hsean/ECE-411-Practicum/Pictures/Concept Pictures/Concept6_Render1.JPG

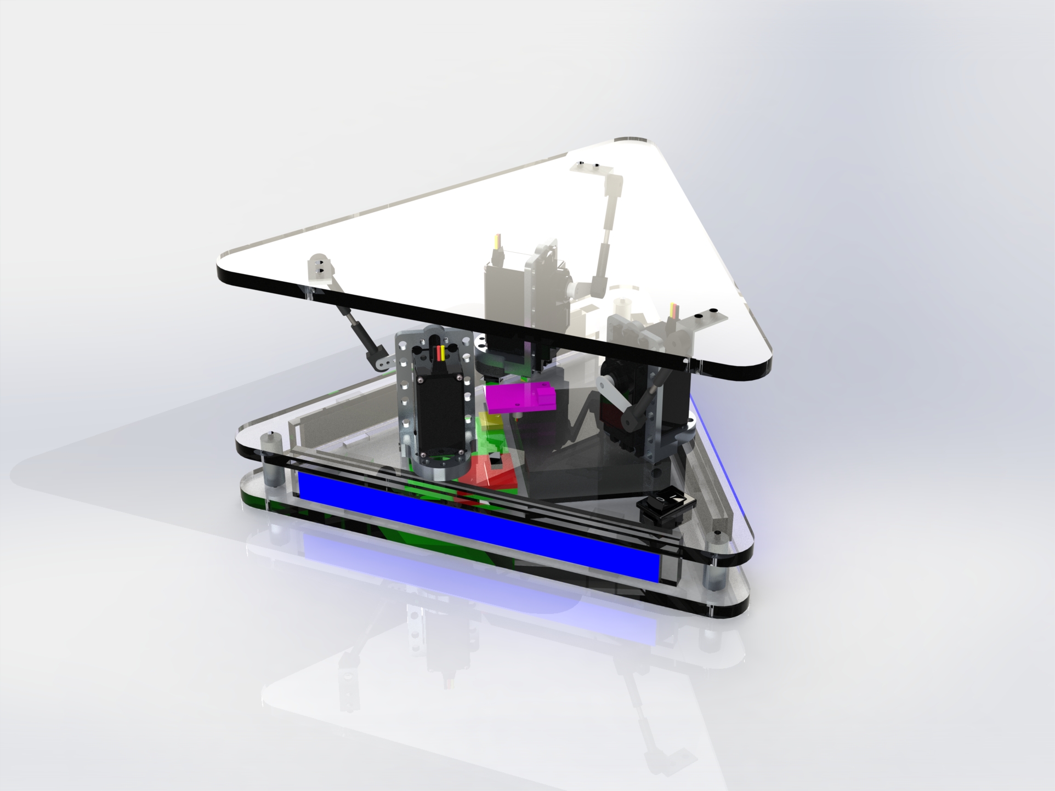
Pictures/Concept Pictures/Concept6_Render1.JPG
