hsean/ECE-411-Practicum/Pictures/Testing/TestProgramMicrocontroller.jpg

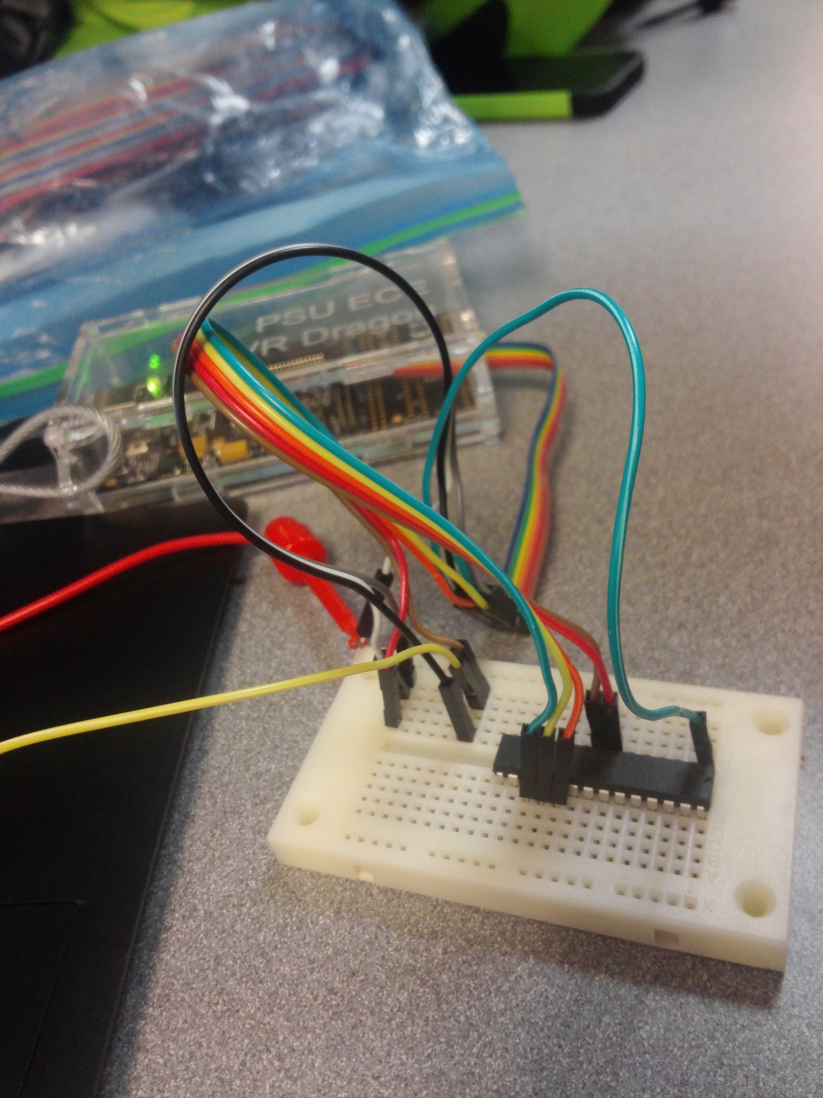
Pictures/Testing/TestProgramMicrocontroller.jpg
