hsean/ECE-411-Practicum/Code/Class Implementation/Readme.txt

The contents of this folder is an object oriented method
for organizing the code for Team 04's project.

Code was written in Visual Studio 2013 Professional.
The project solution thus far is provided in the folder.
