hsean/ECE-411-Practicum/Code/Example Code/BlinkLED/BlinkLED.txt

Taken from: https://electrosome.com/blinking-led-atmega32-avr-microcontroller/
