hsean/ECE-411-Practicum/Block Diagram/HW5_BlockDiagrams.pptx

## T04: Self Leveling Table

Sean Hendrickson
Waleed Alhaddad
Adrian Steele
Taylor Griffin

## Slide 2

Self Leveling Table: Level 0

Gravitational Accelerative Force

Power,
6 VDC

Self Leveling Table

System Status

LED angle
display

Module | Self Leveling Table
Inputs | - Gravitational Accelerative Force: The external forces acting on the device, used to determine the angle of the device and set servo position - Power: 6 VDC from batteries.
Outputs | - LED Angle Display: 15 LEDs lit up in different configurations. Lights up based on device tilt slowly changing colors. LEDs around the device become more blue on the device side that is tilted up. LEDs around the device become more red on the device side that is tilted down. - System status: 4 LEDs that light up on PCB. First LED is green, displays when tilt on the x axis reaches its limit. Second LED is yellow, displays when there is communication between the microcontroller and the servo controller. Third LED is yellow, displays when there is communication between the microcontroller and 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
Functionality | - Consists of 2 layers: the base (two triangular acrylic sheets enclosing the batteries, PCB, servos, and LEDs), and the top tray (one triangular acrylic sheet leveled by servos). Receives input from an accelerometer and determines servo position to keep the top tray level.

## Slide 3

Self Leveling Table Design: Level 1

Oscillator

Gravitational Accelerative Force

Accelerometer

Accelerometer
Initialization

Microcontroller

clock

x y z
values

Status info

Status LEDs

Servo Controller

System Status

3.3 VDC

LED strip
control

Servo
settings
and
positions

Servo 1

Voltage Regulator
6V to 3.3V

PWM
signal
specifying
servo arm
position

Servo 2

Leveled
table

Logic level shifter

Shifted LED
Strip control

Shifted
servo positions

Servo 3

Voltage Regulator
6V to 5V

5 VDC

LED Strip

LED angle
display

Power,
6 VDC

## Slide 4

Accelerometer: Level 0

Gravitational Accelerative Force

Accelerometer Initialization

Power,
3.3 VDC

Accelerometer

x y z values

Module | Accelerometer
Inputs | - Gravitational Accelerative Force: The accelerative force acting on the accelerometer - Power: Regulated 3.3 VDC - Accelerometer Initialization: Set 50 Hz sample rate, fast read mode (ignore last 4 data bits for x y z output), and activate output. Communicated via TWI. TWI format - send start condition, send accelerometer slave address (0x3A), send register to write to (0x23 - system control register 1), send value to put in register (0x23 - bit 5 = 1 bit 4 = 0 bit 3 = 0 data rate to 50 Hz, bit 1 = 1 fast read mode, bit 0 = 1 active mode), send stop condition.
Outputs | - x y z values: 8 most significant bits of 12, expressed in 2’s complement, representing 1 of 256 values on a ± 2 g scale transmitted over TWI
Functionality | - Measures the accelerative forces, and outputs the values of the x y z directions.

## Slide 5

Voltage Regulator 6V to 3.3V: Level 0

Voltage Regulator
6V to 3.3V

Power,
6 VDC

Power,
3.3 VDC

Module | Voltage Regulator 6V to 3.3V
Inputs | 6 V battery power supply
Outputs | Regulated 3.3 VDC
Functionality | - Lowers the incoming 5-20 volts down to a regulated 3.3 VDC, outputting up to 500 mA

## Slide 6

Voltage Regulator 6V to 5V: Level 0

Voltage Regulator
6V to 5V

Power,
6 VDC

Power,
5 VDC

Module | Voltage Regulator 6V to 5V
Inputs | 6 V battery power supply
Outputs | Regulated 5 VDC
Functionality | - Lowers the incoming 6-26 volts down to a regulated 5 VDC, outputting up to 1 A

## Slide 7

Microcontroller: Level 0

Power,
3.3 VDC

Clock

Microcontroller

LED Strip Control

Status info

Accelerometer Initialization

Servo Positions

x y z values

Servo settings

Module | Microcontroller
Inputs | - Power: Regulated 3.3 VDC - Clock: 8 MHz - x y z input: 8 most significant bits of 12, expressed in 2’s complement, representing 1 of 256 values on a ± 2 g scale transmitted over TWI
Outputs | - LED Strip control: which LEDs to light up. Communicated via SPI. Send 24 bit color pattern, shifted through the strip. - Status info: 4 LEDs representing transmission maximum tilt statuses. Using 3.3 V GPIO. 1 green LED displaying when the tilt on the x axis has reached its limit. 2 yellow LEDs displaying when there is communication between the microcontroller and the accelerometer/servo controller. 1 Red LED displaying when the tilt on the y axis has reached its limit. - Servo settings: Set the speed of the servos. speed limit is given in units of (0.25 μs)/(10 ms). Communicated via USART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
Functionality | - Converts x y z values to angles. Runs calculation of correct servo position based on input provided by accelerometer. Also sends LED strips configurations based on current servo positions. Displays system status via 4 LEDs on PCB

## Slide 8

Logic level shifter: Level 0

Power,
5 VDC

LED strip
control

Servo
positions

Logic level shifter

Shifted LED strip control

Shifted servo positions

Module | Logic Level Shifter
Inputs | Power: Regulated 5 VDC LED Strip Control: LED display signals coming from microcontroller Servo position: servo position signals coming from microcontroller
Outputs | Shifted LED Strip Control: Shifted LED signals from 3.3 to 5 V Shifted Servo position: Shifted servo position signals from 3.3 to 5 V
Functionality | - Shifts signals coming in from the microcontroller to a 5 V output

## Slide 9

Oscillator: Level 0

Oscillator

Clock

Module | Oscillator
Inputs
Outputs | Clock: 16 MHz
Functionality | - Sends the microcontroller an 8 MHz clock pulse

## Slide 10

Status LEDs: Level 0

Status LEDs

Status Info

System status

Module | Status LEDs
Inputs | - Status Info: High or low signal depending on which LEDs to turn on. Communicated via 3.3 V GPIO
Outputs | - System status: 4 LEDs that light up on PCB. First LED is green, displays when tilt on the x axis reaches its limit. Second LED is yellow, displays when there is communication between the microcontroller and the servo controller. Third LED is yellow, displays when there is communication between the microcontroller and the accelerometer. Fourth LED is red, displays when the tilt on the y axis reaches its limit.
Functionality | - Displays status information including what transmissions are occurring (TWI, USART) and any errors

## Slide 11

Servo Controller: Level 0

Servo Controller

Power,
5 VDC

Servo positions

PWM signal

Module | Servo Controller
Inputs | - Servo settings: Set the speed of the servos. speed limit is given in units of (0.25 μs)/(10 ms). Communicated via USART. Incoming communications can have varying baud rates but the ideal baud rate is 9600. Transmissions must follow the pololu protocol format and be transmitted one byte at a time (0xAA baud rate detection byte, 0x0C device ID of servo controller, 0x07 command byte to set servo speed, <channel number> channel of the servo that you want to set the speed, <servo speed MSB> least significant byte of speed value, <servo speed MSB> most significant byte of speed value) - Power: R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
Outputs | - Servo positions: Pulse width modulation signal to corresponding servo. Generates a pulse of a certain frequency to send to the servo what position it should hold. Done automatically, just need to receive input on what position to set the servo to.
Functionality | - Creating pulse width modulated signals to control up to 6 servos.

## Slide 12

LED Strip: Level 0

LED Strip

Power,
5 VDC

LED Angle Display

LED Strip control

Module | LED Strip
Inputs | Power: Regulated 5 VDC LED Strip control: which LEDs to light up. Communicated via SPI. Send 24 bit color pattern, shifted through the strip.
Outputs | Power: Regulated 5 VDC LED Strip control: which LEDs to light up. Communicated via SPI. Send 24 bit color pattern, shifted through the strip.
Functionality | - Decorative LED display based on each servo’s position. Should not consume more than 1 A. Multicolored.

## Slide 13

Servos: Level 0

Servos

Power,
6 VDC

Leveled Table

PWM signal

Module | LED Strip
Inputs | - Power: 6 VDC - Servo positions: Pulse width modulation signal to corresponding servo. Generates a pulse of a certain frequency to send to the servo what position it should hold. Done automatically, just need to receive input on what position to set the servo to.
Outputs | Leveled table: Adjust servo positions to level the top tray
Functionality | - The servo position is determined by the main program so that they keep the tray balanced. Range of 140°

## UML: Activity Diagram

Power on device

Set servos to home position

Initialize accelerometer

Sample Accelerometer

Convert accelerometer data to angles

Calculate servo positions

If servo positions different by 4 degrees or more

No

Yes

Send positions to servos

Update LED strip

Delay

Repeat until powered off

*Note: Update status LEDs after every communication and calculation and in the event of an error.

## UML: Interaction Diagram

Accelerometer

Status LEDs

Microprocessor

LED Strip

1. Set servo speed and move them to home position

Servo Controller

Servos

3. Move servos

4. Initialize Accelerometer

6. Request accelerometer data

7. Transmit accelerometer data

8. Update Status

9. Calculate
servo positions

11. Update Status

10. Send positions to servos if previous
Position differs by 4 or more degrees

12. Move servos

13. Update LED Strip

15. Repeat steps 6 - 15
