hsean/ECE-411-Practicum/Code/DotStar_Code/Pictures/C Code.JPG

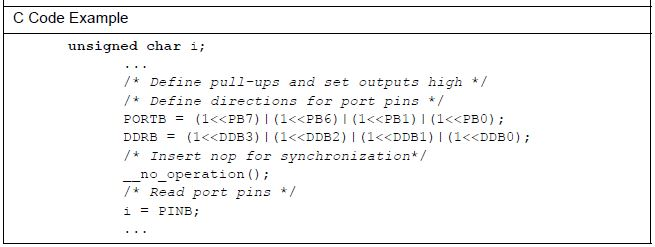
Code/DotStar_Code/Pictures/C Code.JPG
