hsean/ECE-411-Practicum/Code/DotStar_Code/Pictures/Configuring GPIO pin.JPG

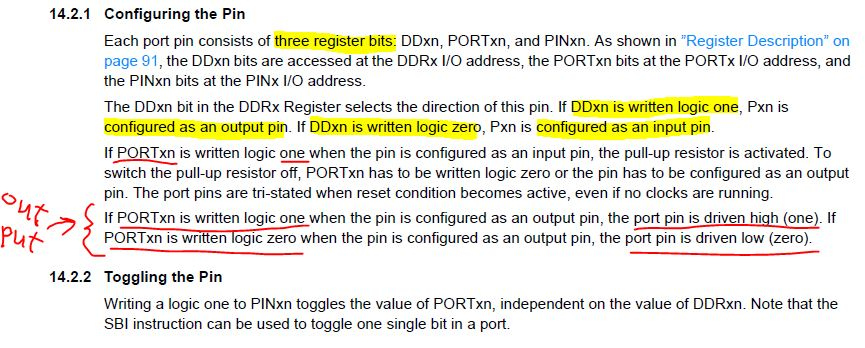
Code/DotStar_Code/Pictures/Configuring GPIO pin.JPG
