hsean/ECE-411-Practicum/Code/DotStar_Code/Pictures/Data Structure.JPG

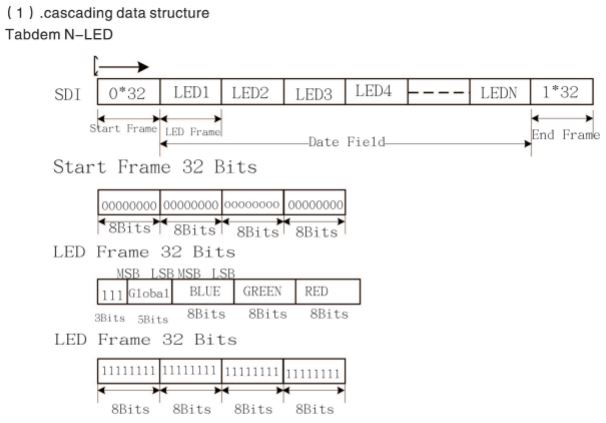
Code/DotStar_Code/Pictures/Data Structure.JPG
