hsean/ECE-411-Practicum/Code/DotStar_Code/Pictures/Dotstar datapath.JPG

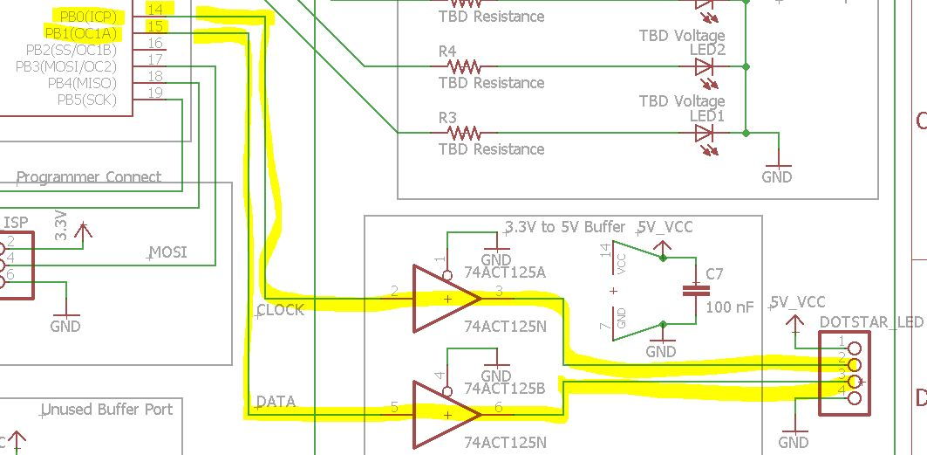
Code/DotStar_Code/Pictures/Dotstar datapath.JPG
