hsean/ECE-411-Practicum/Code/DotStar_Code/Pictures/Dotstar pinout.JPG

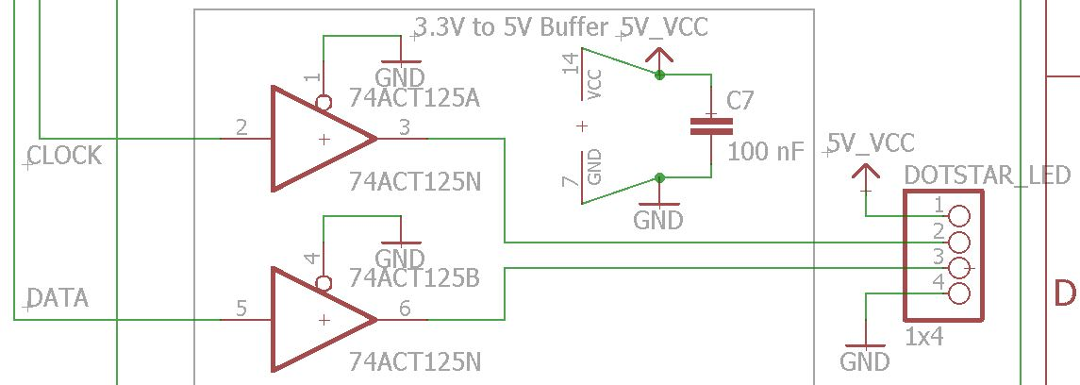
Code/DotStar_Code/Pictures/Dotstar pinout.JPG
