hsean/ECE-411-Practicum/Code/DotStar_Code/Pictures/MCPins&Ports.JPG

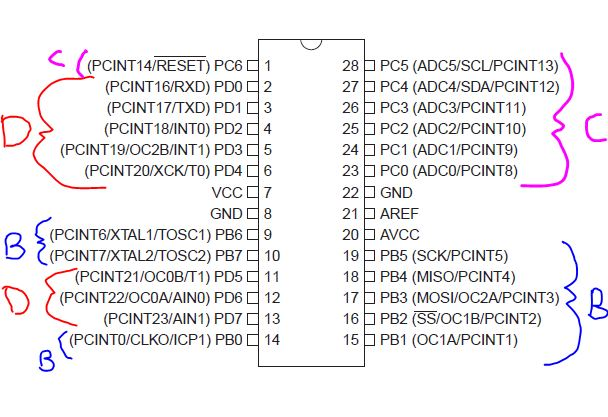
Code/DotStar_Code/Pictures/MCPins&Ports.JPG
