hsean/ECE-411-Practicum/Code/DotStar_Code/Pictures/Microcontroller.JPG

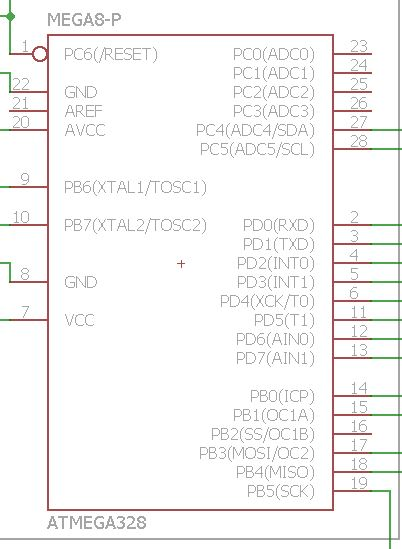
Code/DotStar_Code/Pictures/Microcontroller.JPG
