hsean/ECE-411-Practicum/Code/DotStar_Code/Pictures/PORTB Registers.JPG

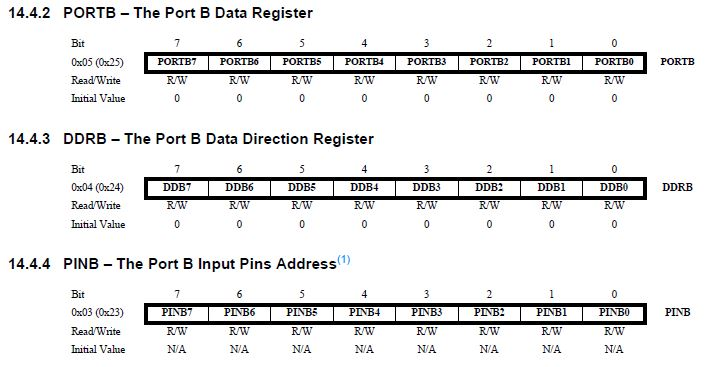
Code/DotStar_Code/Pictures/PORTB Registers.JPG
