hsean/ECE-411-Practicum/Code/DotStar_Code/Pictures/PORTD Registers.JPG

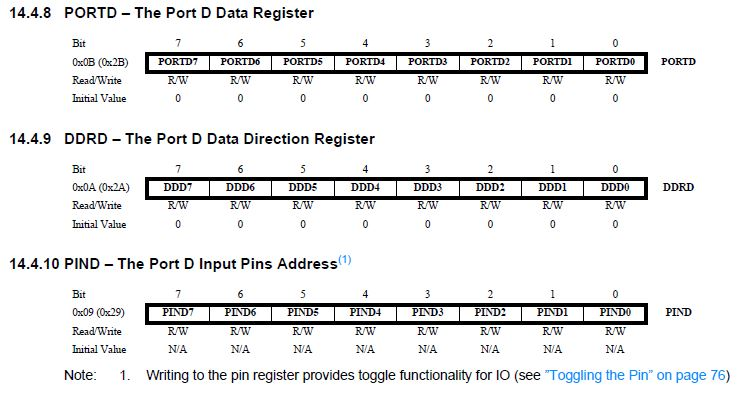
Code/DotStar_Code/Pictures/PORTD Registers.JPG
