hsean/ECE-411-Practicum/Code/DotStar_Code/Pictures/Status LED Pins.JPG

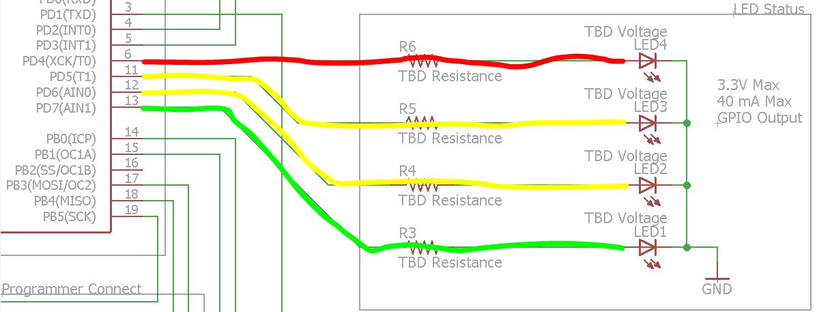
Code/DotStar_Code/Pictures/Status LED Pins.JPG
