hsean/ECE-411-Practicum/Code/DotStar_Code/Pictures/Switching between input and output.JPG

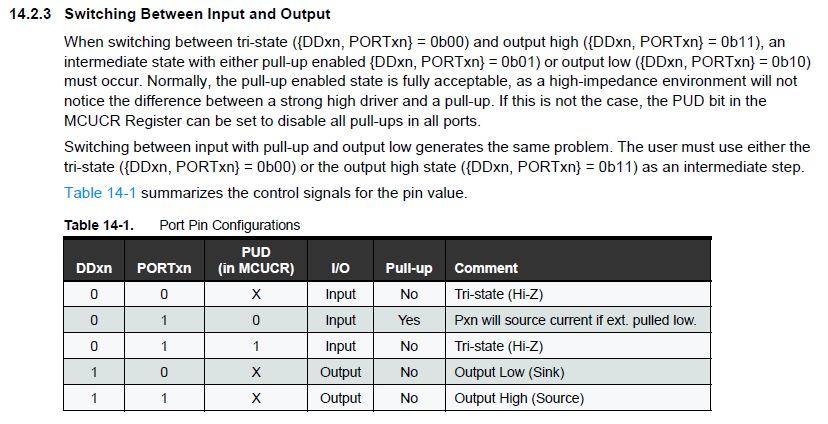
Code/DotStar_Code/Pictures/Switching between input and output.JPG
