hsean/ECE-411-Practicum/Gantt Chart/Example1_MSProject.JPG

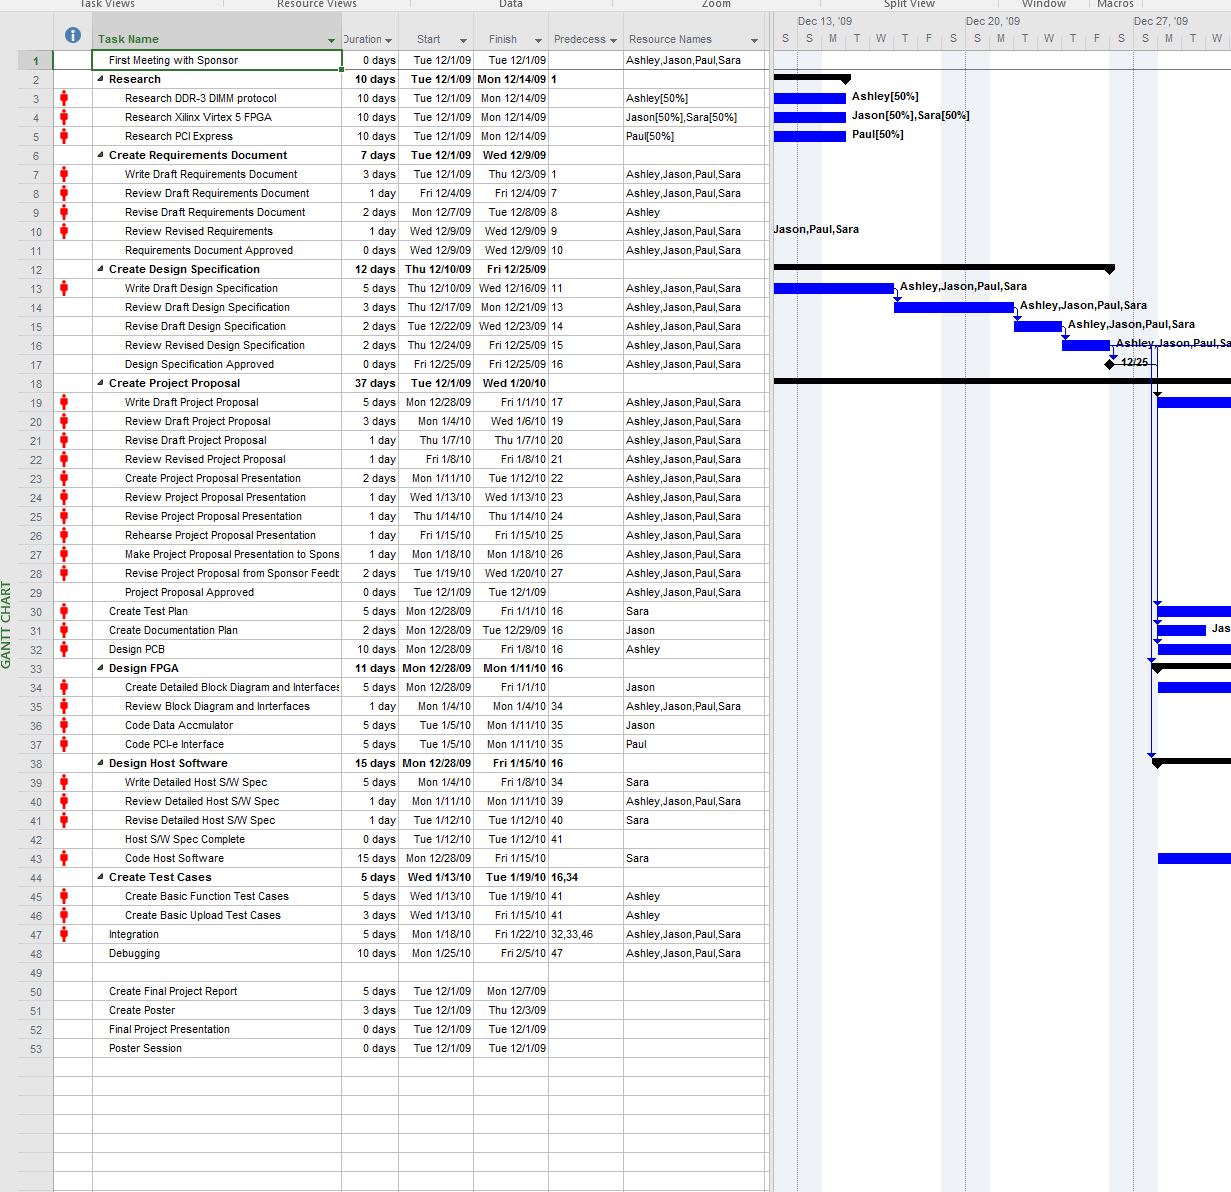
Gantt Chart/Example1_MSProject.JPG
