hsean/ECE-411-Practicum/Pictures/Concept Pictures/Concept5_Render1.JPG

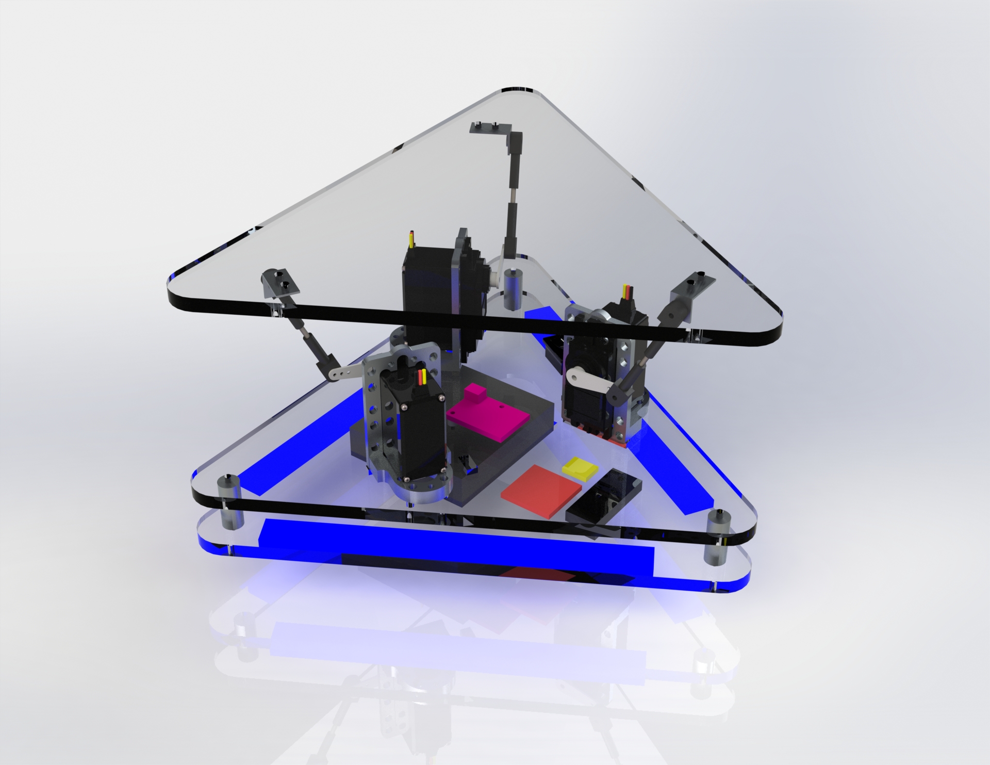
Pictures/Concept Pictures/Concept5_Render1.JPG
