hsean/ECE-411-Practicum/Pictures/Concept Pictures/Concept5_Render3.JPG

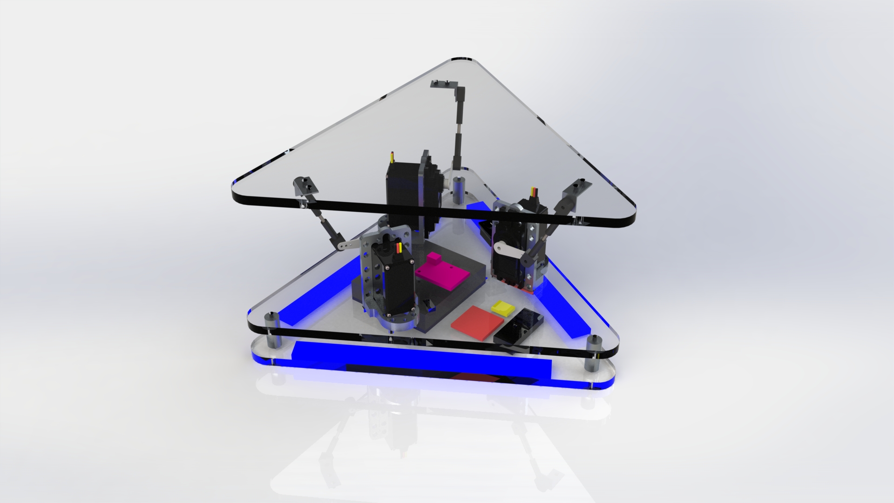
Pictures/Concept Pictures/Concept5_Render3.JPG
