hsean/ECE-411-Practicum/Pictures/Concept Pictures/Concept6_Render2.JPG

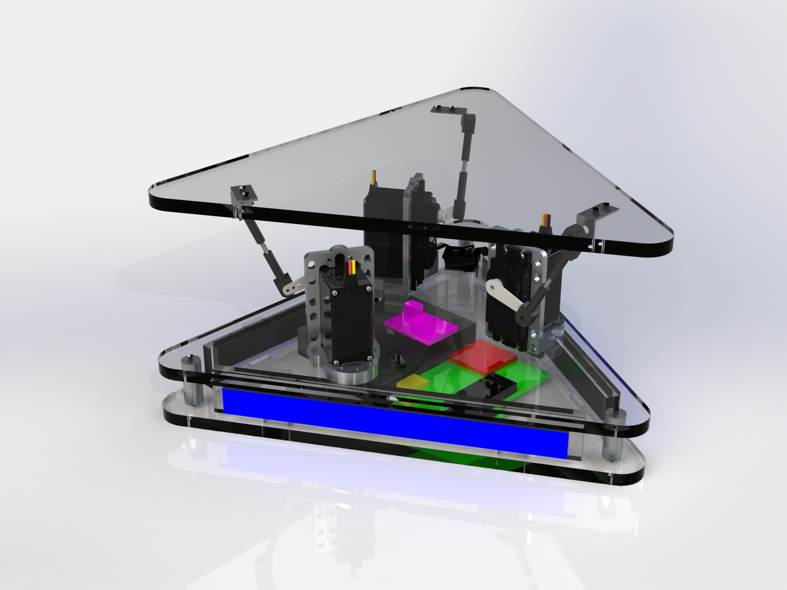
Pictures/Concept Pictures/Concept6_Render2.JPG
