hsean/ECE-411-Practicum/Pictures/Concept Pictures/Concept7_wScrews_Render2.JPG

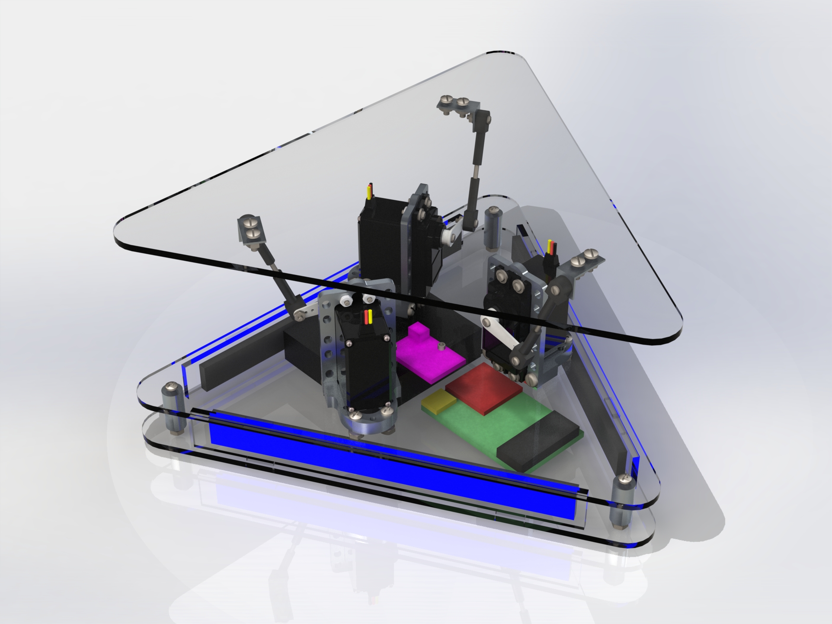
Pictures/Concept Pictures/Concept7_wScrews_Render2.JPG
