hsean/ECE-411-Practicum/Pictures/Concept Pictures/Concept7_wScrews_Render3.JPG

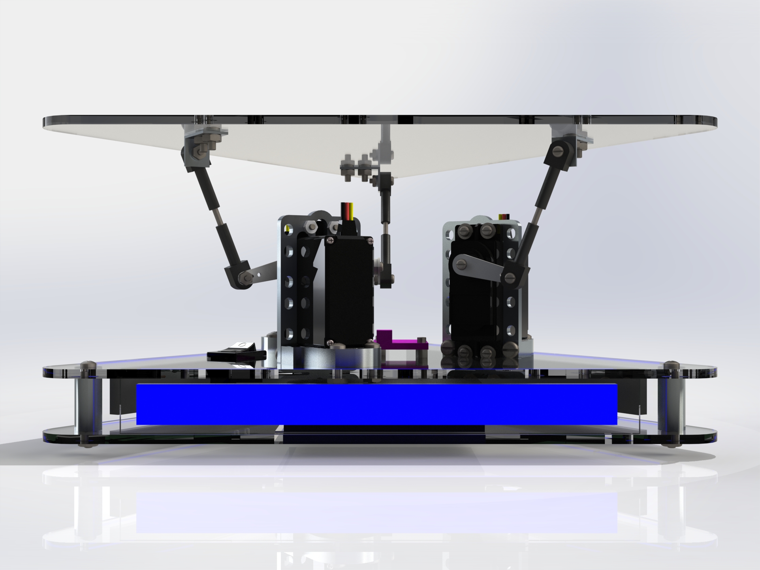
Pictures/Concept Pictures/Concept7_wScrews_Render3.JPG
