hsean/ECE-411-Practicum/Pictures/Concept Pictures/LD_Pic2.JPG

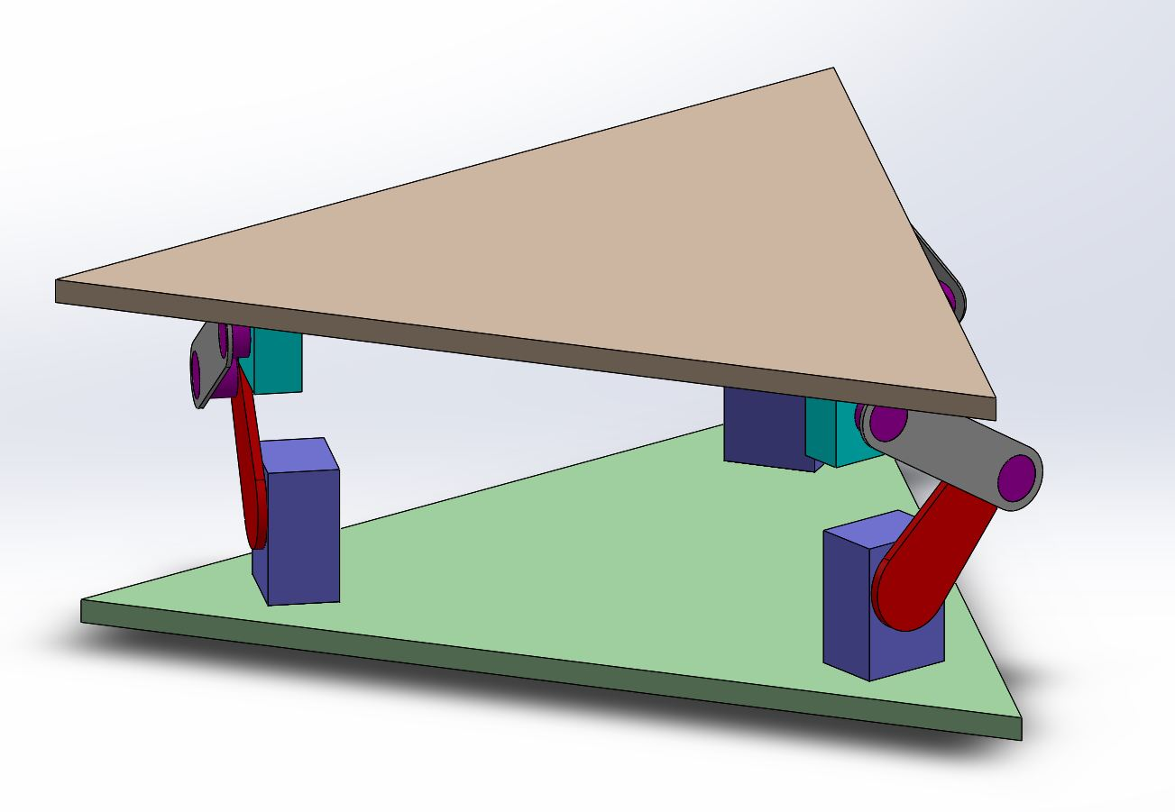
Pictures/Concept Pictures/LD_Pic2.JPG
