hsean/ECE-411-Practicum/Pictures/Concept Pictures/LD_Pic3.JPG

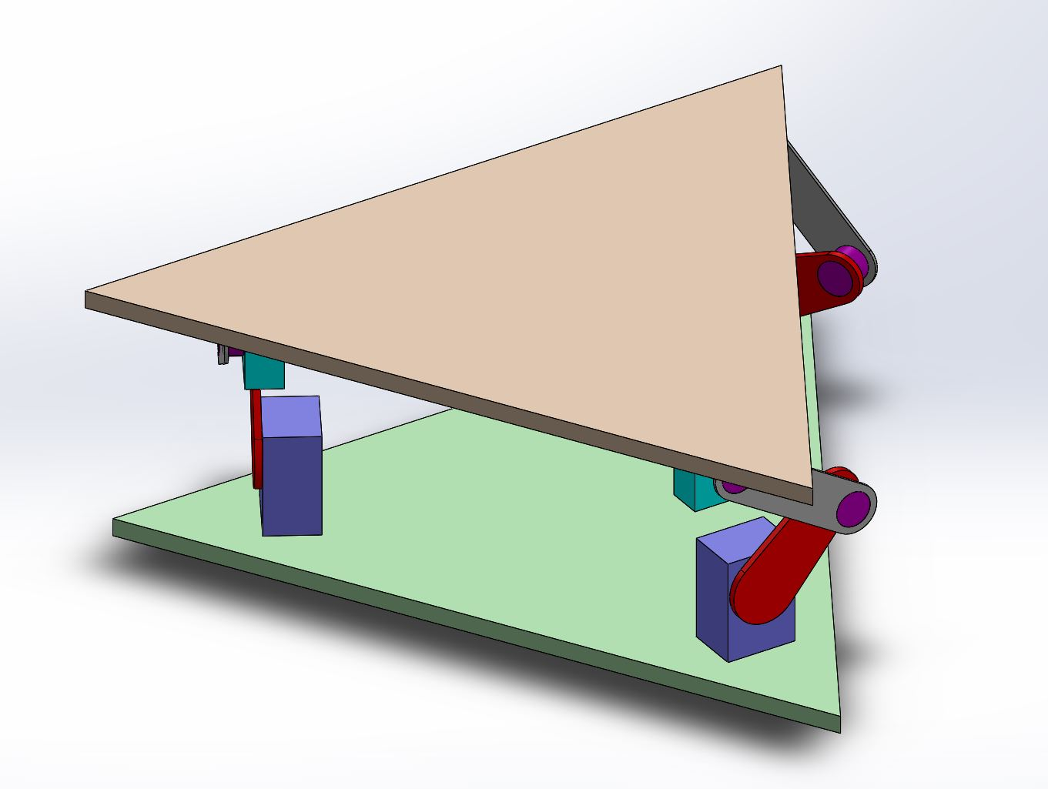
Pictures/Concept Pictures/LD_Pic3.JPG
