hsean/ECE-411-Practicum/Pictures/Concept Pictures/LD_Pic4.JPG

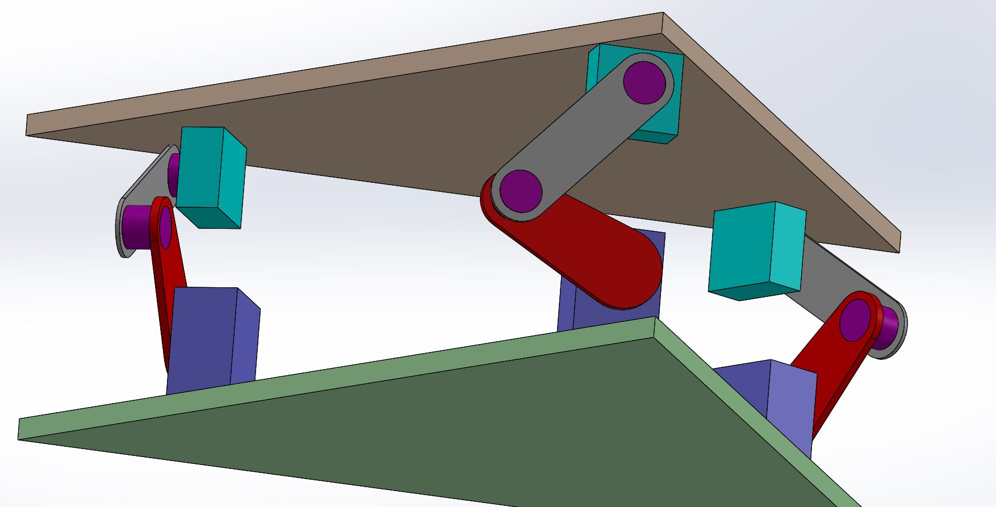
Pictures/Concept Pictures/LD_Pic4.JPG
