hsean/ECE-411-Practicum/Pictures/Cut Acrylic/20151125_133330.jpg

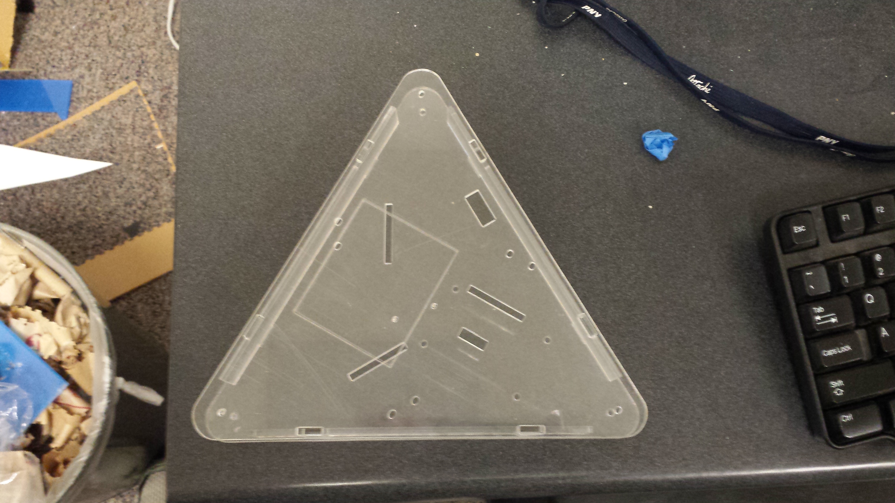
Pictures/Cut Acrylic/20151125_133330.jpg
