hsean/ECE-411-Practicum/Pictures/Cut Acrylic/20151125_133339.jpg

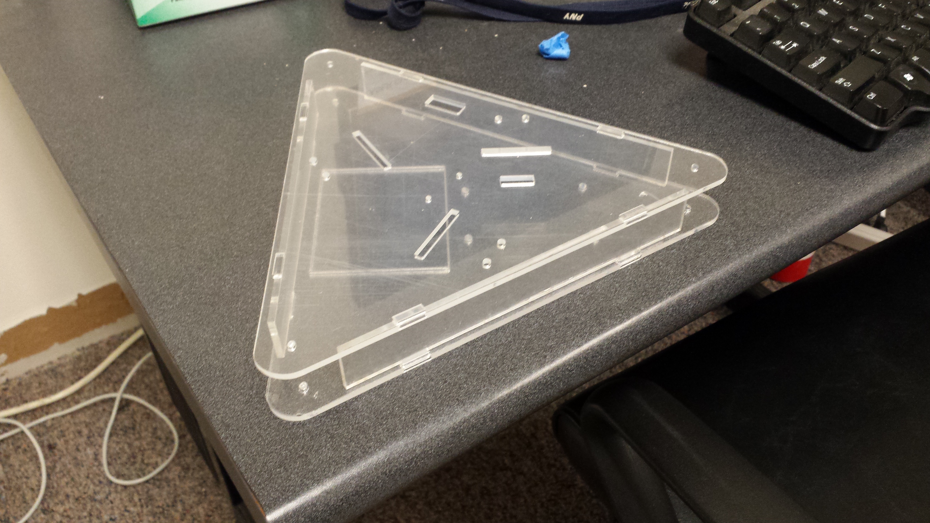
Pictures/Cut Acrylic/20151125_133339.jpg
