hsean/ECE-411-Practicum/Pictures/Cut Acrylic/20151125_133359.jpg

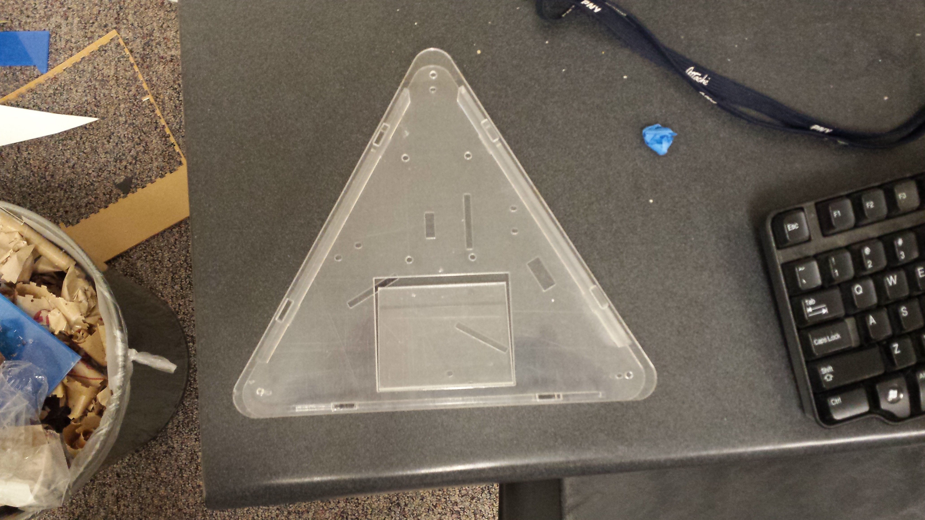
Pictures/Cut Acrylic/20151125_133359.jpg
