hsean/ECE-411-Practicum/Pictures/Cut Acrylic/20151125_133409.jpg

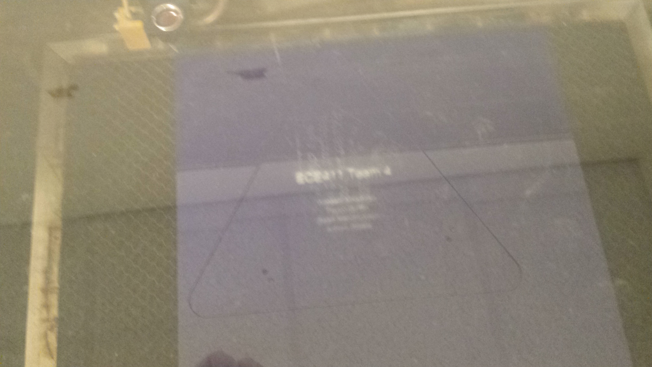
Pictures/Cut Acrylic/20151125_133409.jpg
