hsean/ECE-411-Practicum/Pictures/Cut Acrylic/20151125_134505.jpg

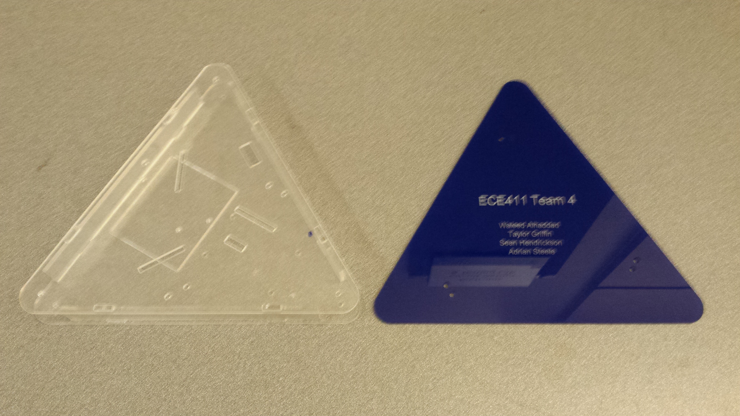
Pictures/Cut Acrylic/20151125_134505.jpg
