hsean/ECE-411-Practicum/Pictures/Cut Acrylic/20151125_134540.jpg

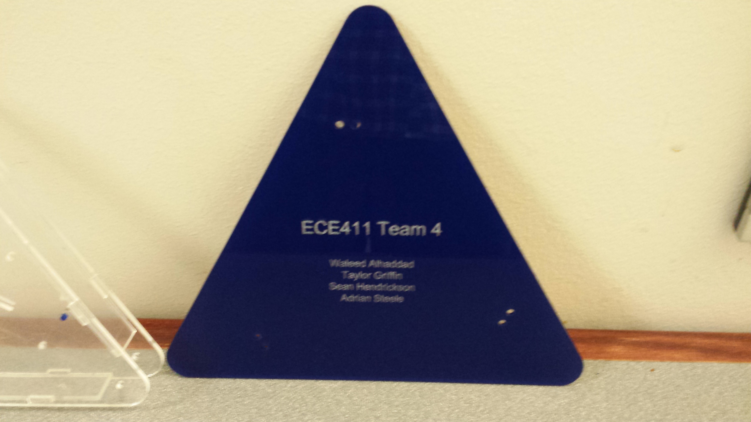
Pictures/Cut Acrylic/20151125_134540.jpg
