hsean/ECE-411-Practicum/Pictures/Design Drawings/LowerBase.JPG

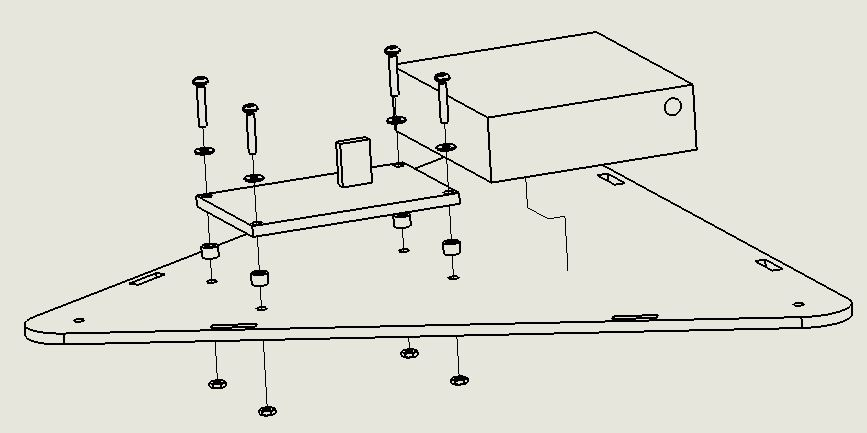
Pictures/Design Drawings/LowerBase.JPG
