hsean/ECE-411-Practicum/Pictures/Design Drawings/TrayMount.JPG

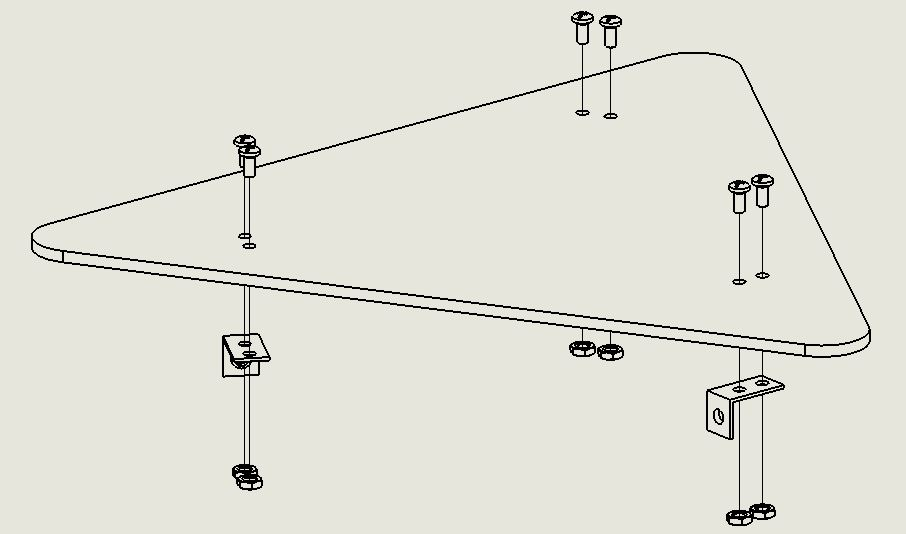
Pictures/Design Drawings/TrayMount.JPG
