hsean/ECE-411-Practicum/Pictures/Info/ATMEGA328_ExternalCrystal.JPG

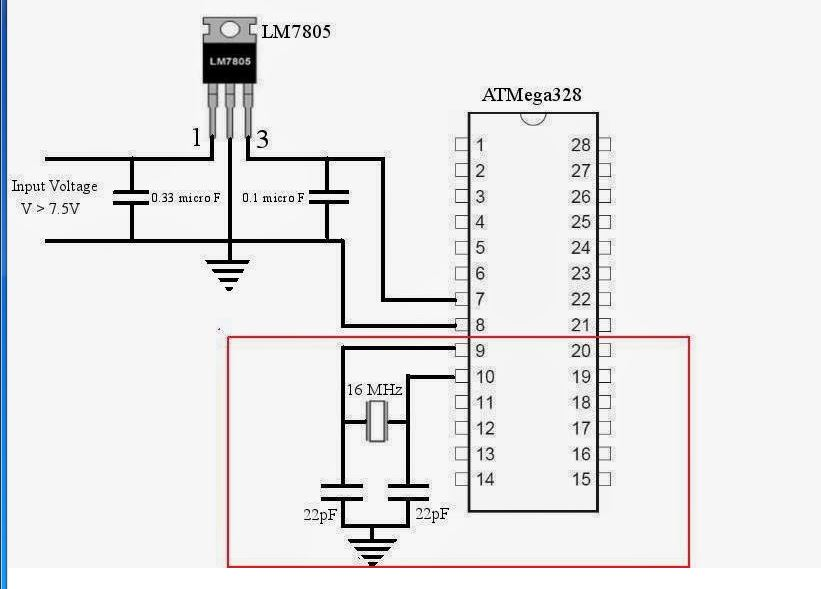
Pictures/Info/ATMEGA328_ExternalCrystal.JPG
