hsean/ECE-411-Practicum/Pictures/Info/base spacing concept.PNG

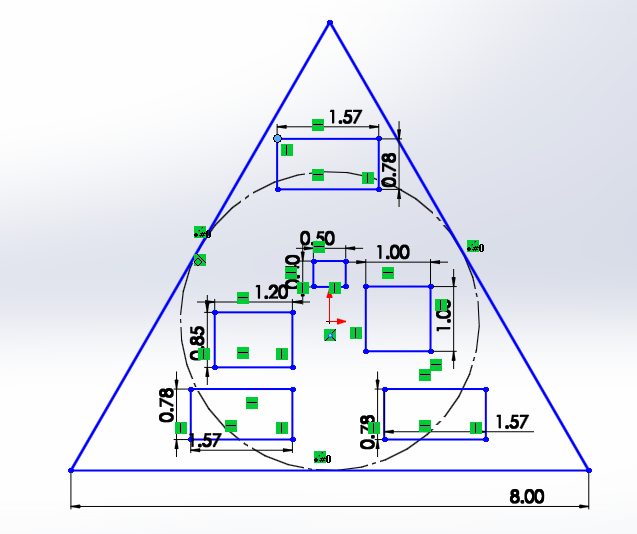
Pictures/Info/base spacing concept.PNG
