hsean/ECE-411-Practicum/Solidworks/Concept9/CompleteModel_v9.SLDASM

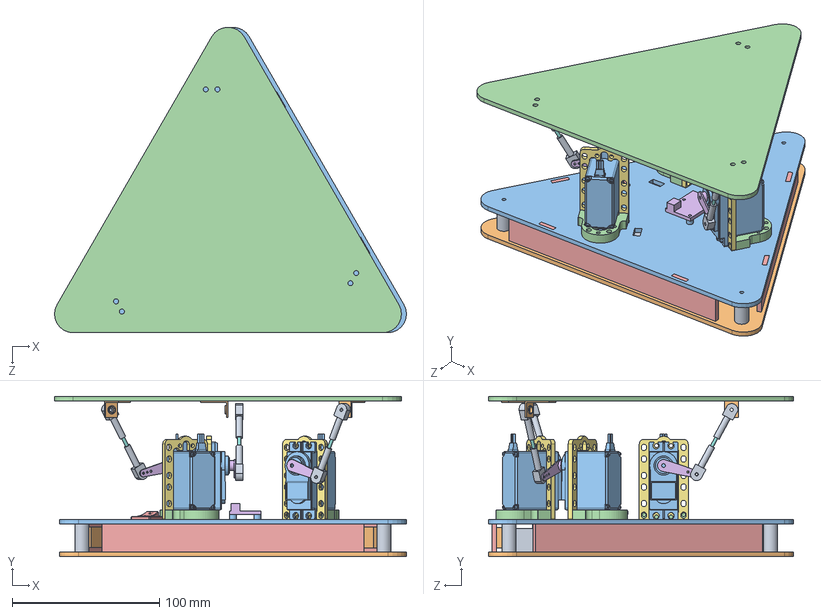
[picture p69: CAD file, 2015-12-10]
Solidworks/Concept9/CompleteModel_v9.SLDASM
238.8 x 108.9 x 207.3 mm
2-56 ball link x 6
DotStarStrip_6LEDs x 3
hs-422_sws x 3
HubMountC x 3
rocker switch 1
ServoArm_Plastic x 3
ServoMountA x 3
2-56 THRDROD x 3
4-40_1in_aluminumStandoff x 3
Base_bottom
Base_top
tray
ATMEGA328
Servo Controller
Sparkfun accelerometer
Voltage Regulator
4AABateryHolder
534-631 Bracket x 3
Nylon_Spacer_125 x 2
PCB_v1
Base Side Panel x 3
