hsean/ECE-411-Practicum/Solidworks/Concept9/tray.SLDPRT

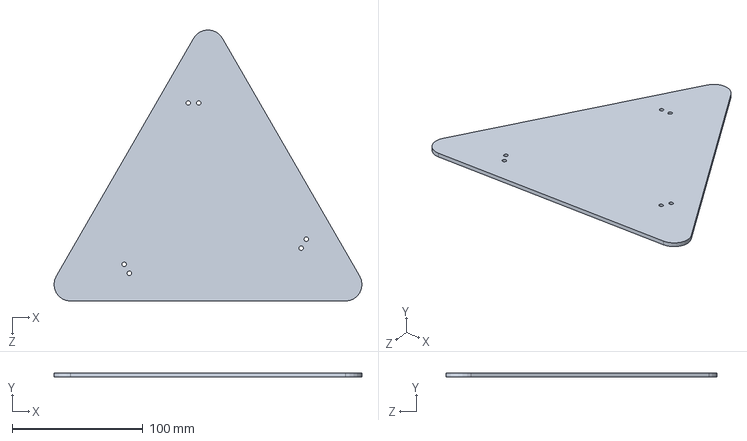
[picture p70: CAD file, 2015-12-10]
Solidworks/Concept9/tray.SLDPRT
235.4 x 3.17 x 207.3 mm
