hsean/ECE-411-Practicum/Solidworks/Concept9/Drawings_for_cutting/Base Side Panel.DXF

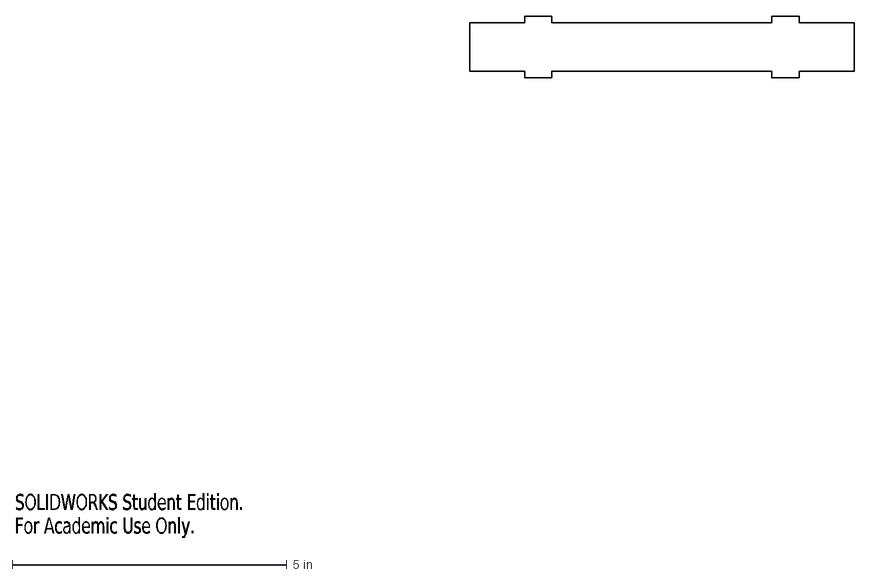
[picture p71: CAD file, 2015-12-10]
Solidworks/Concept9/Drawings_for_cutting/Base Side Panel.DXF
SOLIDWORKS Student Edition.
For Academic Use Only.
