hsean/ECE-411-Practicum/Solidworks/Concept9/Base_top.SLDPRT

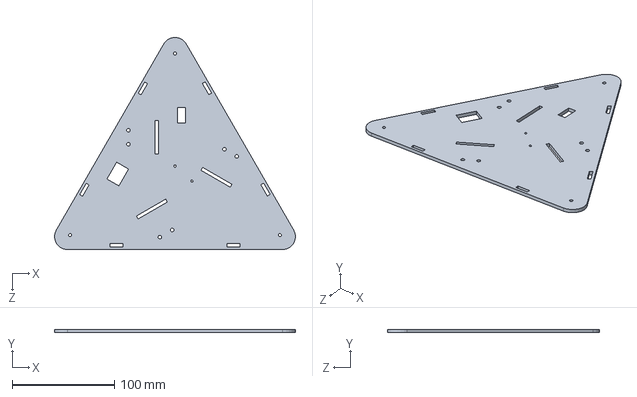
[picture p72: CAD file, 2015-12-10]
Solidworks/Concept9/Base_top.SLDPRT
235.4 x 3.17 x 207.3 mm
