hsean/ECE-411-Practicum/Solidworks/Concept9/Drawings_for_cutting/tray.DXF

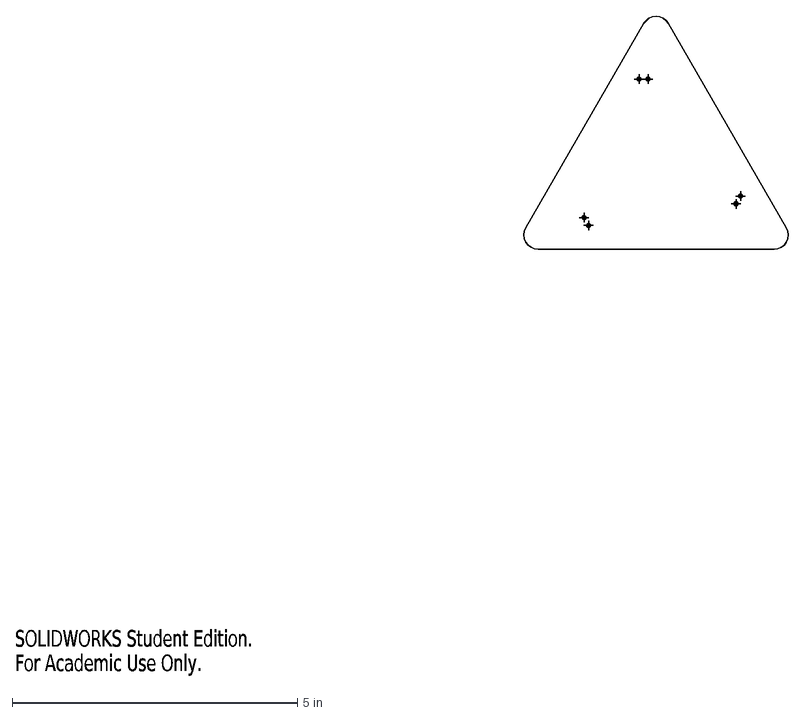
[picture p73: CAD file, 2015-12-10]
Solidworks/Concept9/Drawings_for_cutting/tray.DXF
SOLIDWORKS Student Edition.
For Academic Use Only.
