hsean/ECE-411-Practicum/Solidworks/Concept9/Drawings_for_cutting/Base_bottom.DXF

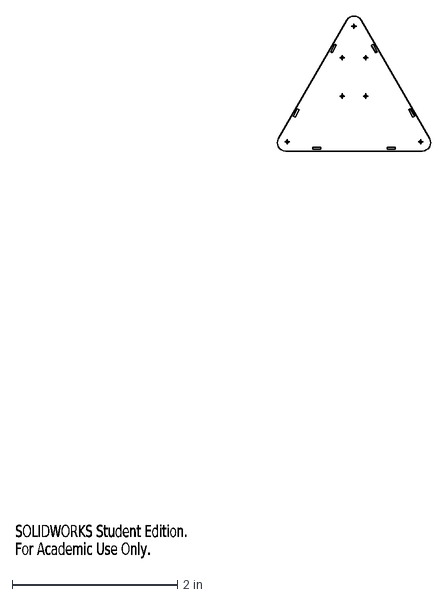
[picture p74: CAD file, 2015-12-10]
Solidworks/Concept9/Drawings_for_cutting/Base_bottom.DXF
SOLIDWORKS Student Edition.
For Academic Use Only.
