hsean/ECE-411-Practicum/Solidworks/Concept9/Nylon_Spacer_125.SLDPRT

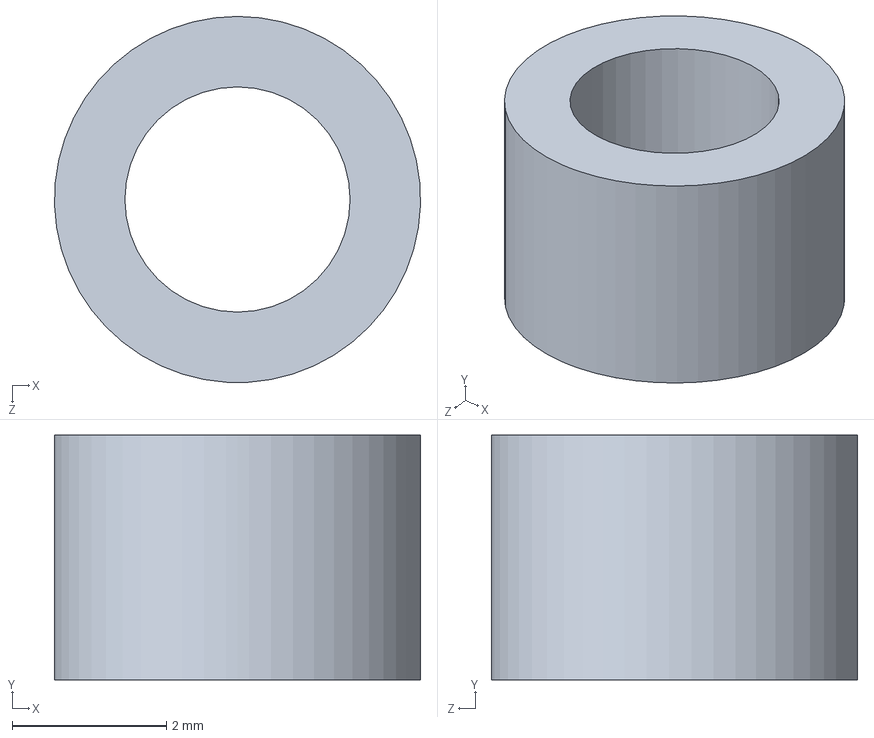
[picture p75: CAD file, 2015-12-10]
Solidworks/Concept9/Nylon_Spacer_125.SLDPRT
4.75 x 3.17 x 4.75 mm
