hsean/ECE-411-Practicum/Solidworks/Concept9/2-56 ball link.SLDPRT

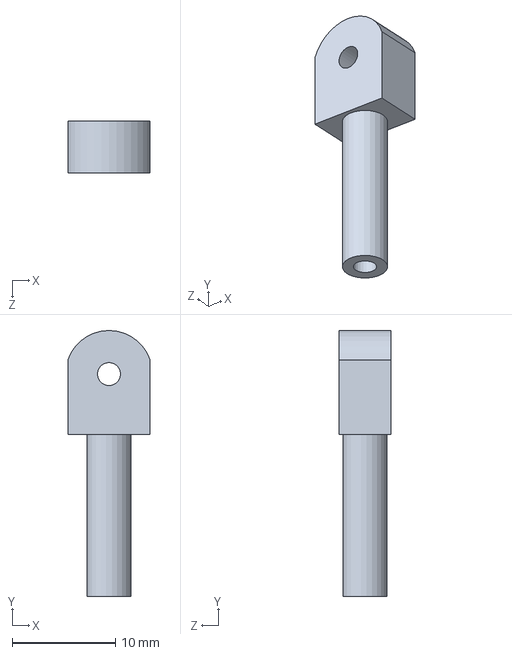
[picture p76: CAD file, 2015-12-10]
Solidworks/Concept9/2-56 ball link.SLDPRT
8.00 x 25.8 x 5.08 mm
