hsean/ECE-411-Practicum/Solidworks/Concept9/Drawings_for_cutting/Base_top.DXF

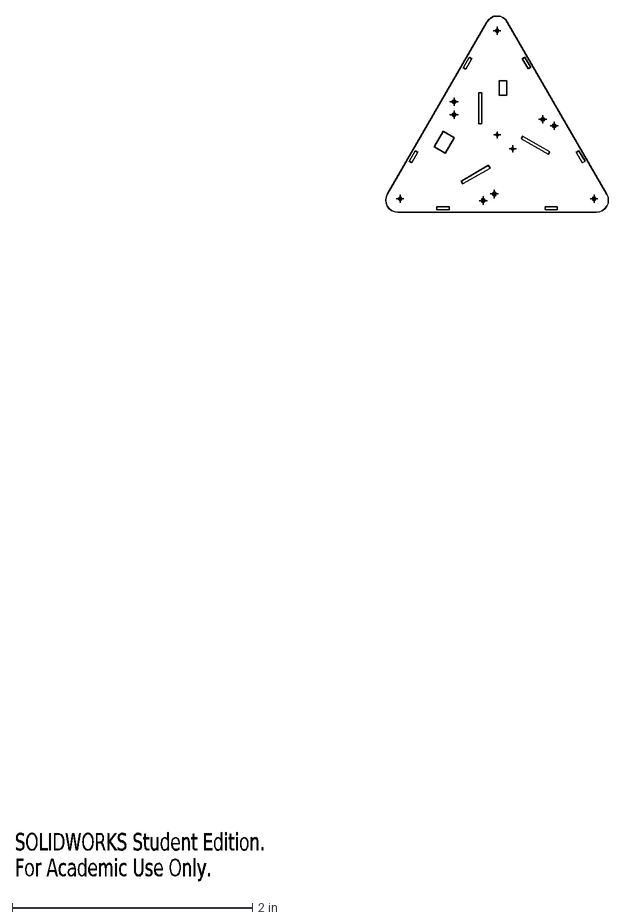
[picture p77: CAD file, 2015-12-10]
Solidworks/Concept9/Drawings_for_cutting/Base_top.DXF
SOLIDWORKS Student Edition.
For Academic Use Only.
