hsean/ECE-411-Practicum/Solidworks/Concept9/PCB_v1.SLDPRT

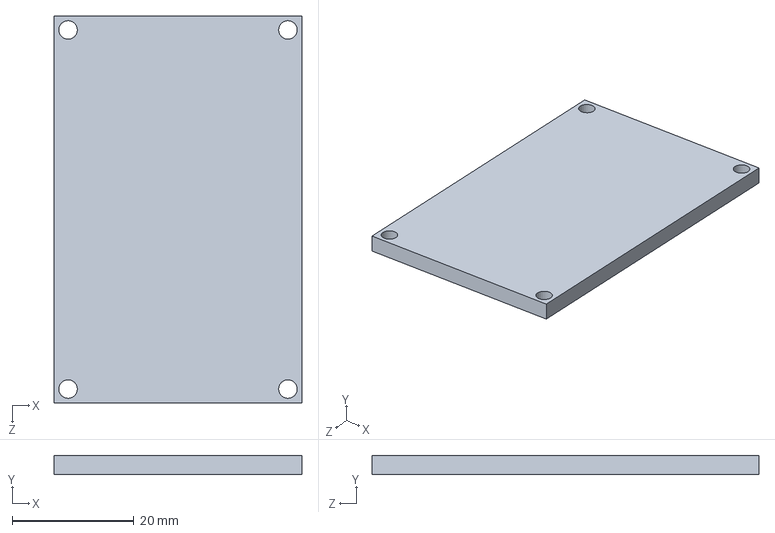
[picture p78: CAD file, 2015-12-10]
Solidworks/Concept9/PCB_v1.SLDPRT
40.6 x 3.17 x 63.5 mm
