hsean/ECE-411-Practicum/Solidworks/Concept9/Base Side Panel.SLDPRT

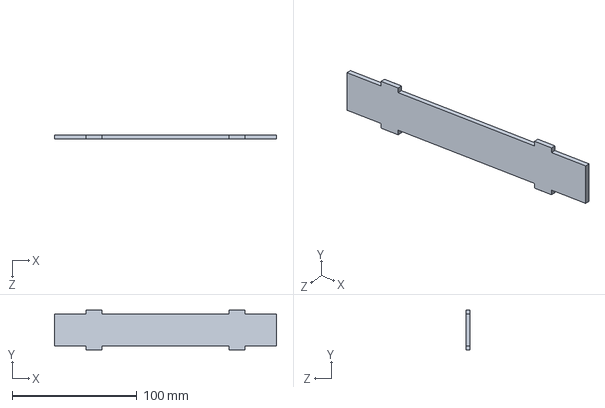
[picture p79: CAD file, 2015-12-10]
Solidworks/Concept9/Base Side Panel.SLDPRT
177.8 x 31.8 x 3.17 mm
