hsean/ECE-411-Practicum/Solidworks/Concept9/4-40_1in_aluminumStandoff.SLDPRT

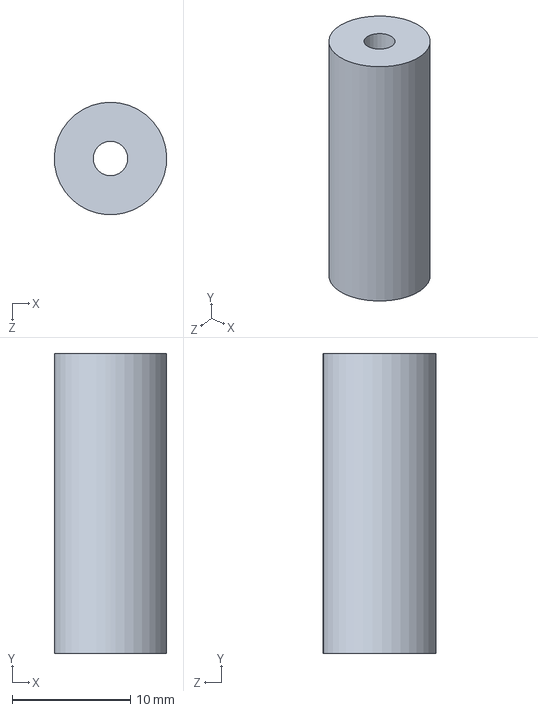
[picture p80: CAD file, 2015-12-10]
Solidworks/Concept9/4-40_1in_aluminumStandoff.SLDPRT
9.52 x 25.4 x 9.53 mm
