hsean/ECE-411-Practicum/Solidworks/Concept9/16Mhz Clock.SLDPRT

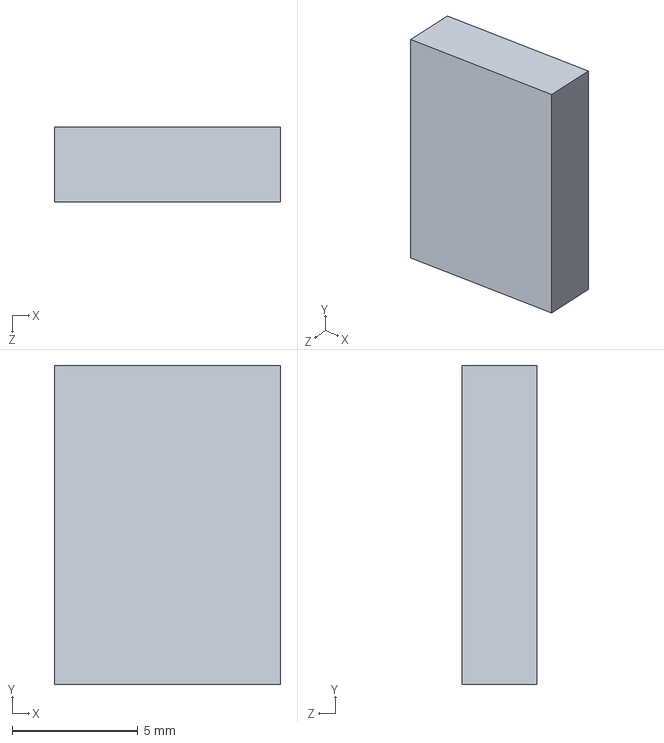
[picture p81: CAD file, 2015-12-10]
Solidworks/Concept9/16Mhz Clock.SLDPRT
9.00 x 12.7 x 3.00 mm
