hsean/ECE-411-Practicum/Solidworks/Concept9/HubMountC.SLDPRT

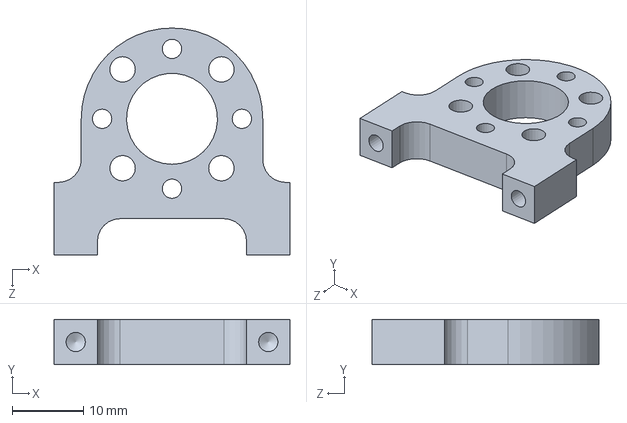
[picture p82: CAD file, 2015-12-10]
Solidworks/Concept9/HubMountC.SLDPRT
33.0 x 6.35 x 31.8 mm
