hsean/ECE-411-Practicum/Solidworks/Concept9/DotStarStrip_6LEDs.SLDPRT

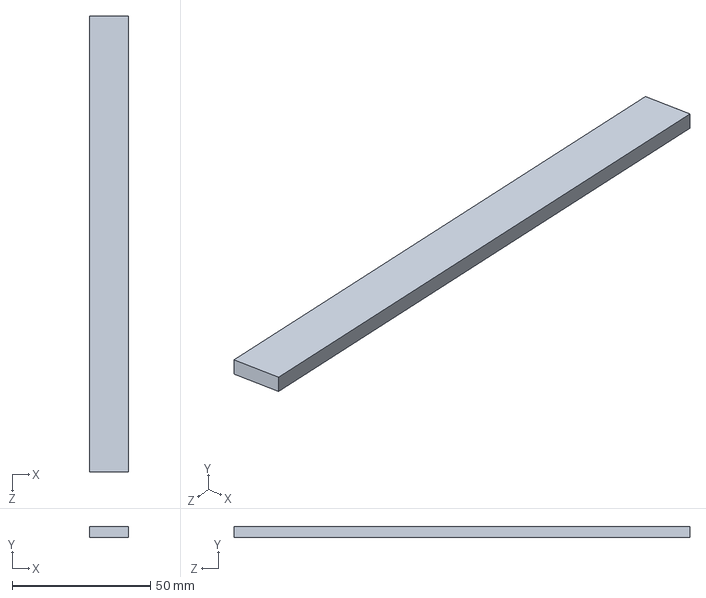
[picture p83: CAD file, 2015-11-10]
Solidworks/Concept9/DotStarStrip_6LEDs.SLDPRT
14.0 x 4.06 x 165.1 mm
