hsean/ECE-411-Practicum/Solidworks/Concept9/Servo Controller.SLDPRT

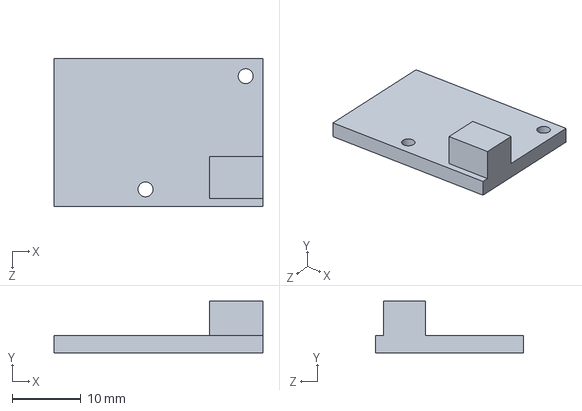
[picture p84: CAD file, 2015-11-09]
Solidworks/Concept9/Servo Controller.SLDPRT
30.5 x 7.54 x 21.6 mm
