hsean/ECE-411-Practicum/Solidworks/Concept9/534-620 Bracket.SLDPRT

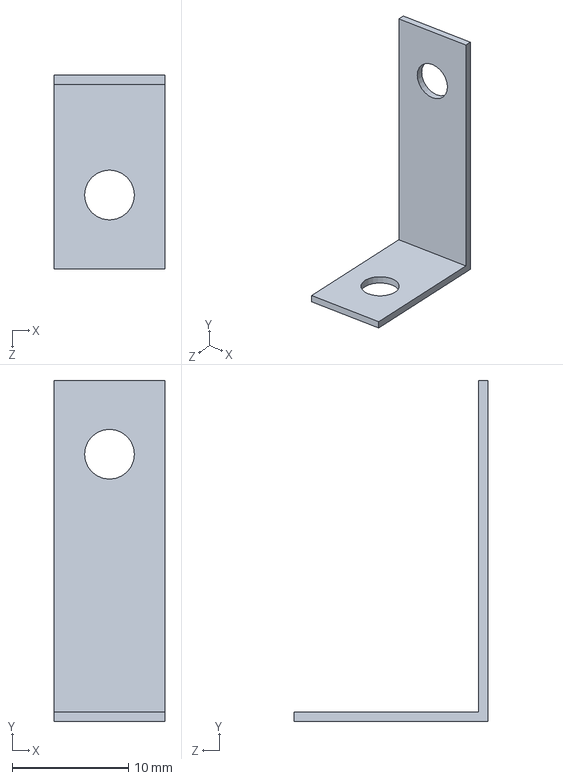
[picture p85: CAD file, 2015-11-09]
Solidworks/Concept9/534-620 Bracket.SLDPRT
9.53 x 29.4 x 16.7 mm
