hsean/ECE-411-Practicum/Solidworks/Concept9/534-631 Bracket.SLDPRT

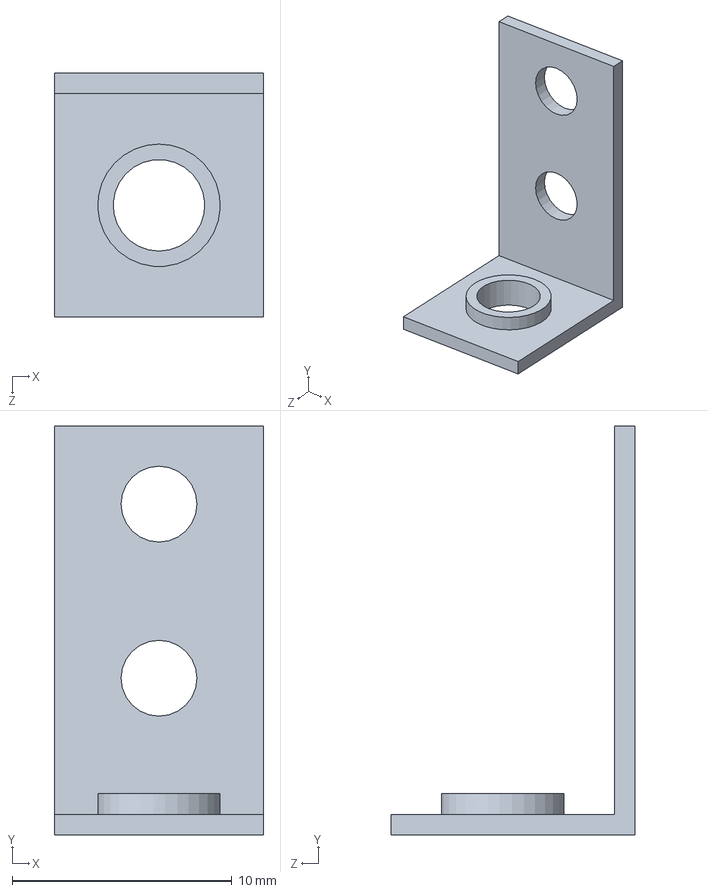
[picture p86: CAD file, 2015-11-09]
Solidworks/Concept9/534-631 Bracket.SLDPRT
9.53 x 18.6 x 11.1 mm
