hsean/ECE-411-Practicum/Solidworks/Concept9/2-56 THRDROD.SLDPRT

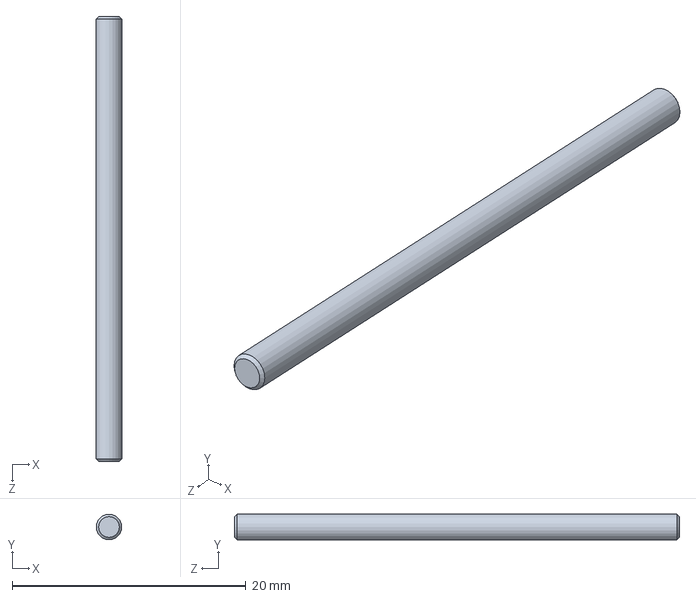
[picture p87: CAD file, 2015-11-09]
Solidworks/Concept9/2-56 THRDROD.SLDPRT
2.18 x 2.18 x 38.1 mm
