hsean/ECE-411-Practicum/Solidworks/Concept9/ServoArm_Plastic.SLDPRT

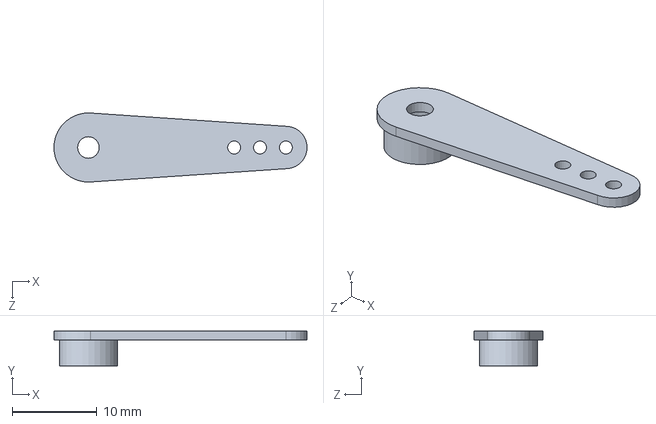
[picture p88: CAD file, 2015-11-09]
Solidworks/Concept9/ServoArm_Plastic.SLDPRT
29.8 x 4.06 x 8.11 mm
