hsean/ECE-411-Practicum/Solidworks/Concept9/4AABateryHolder.SLDPRT

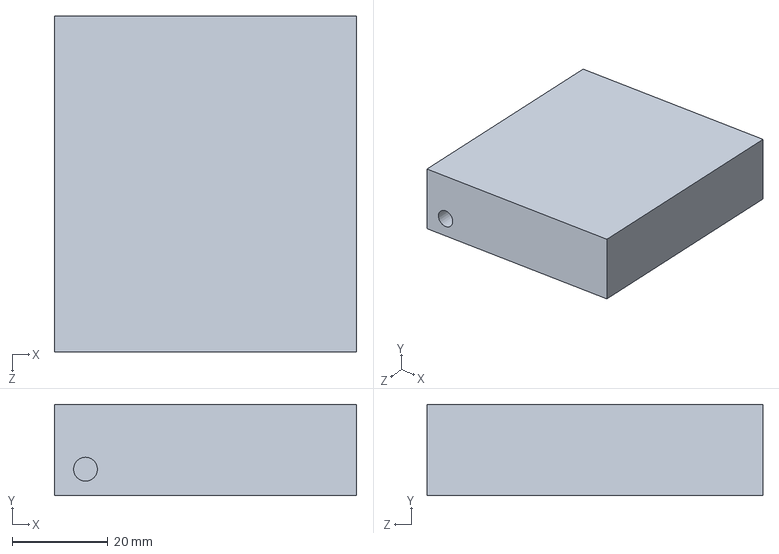
[picture p89: CAD file, 2015-11-09]
Solidworks/Concept9/4AABateryHolder.SLDPRT
63.0 x 19.0 x 70.0 mm
