hsean/ECE-411-Practicum/Solidworks/Concept9/rocker switch 1.SLDPRT

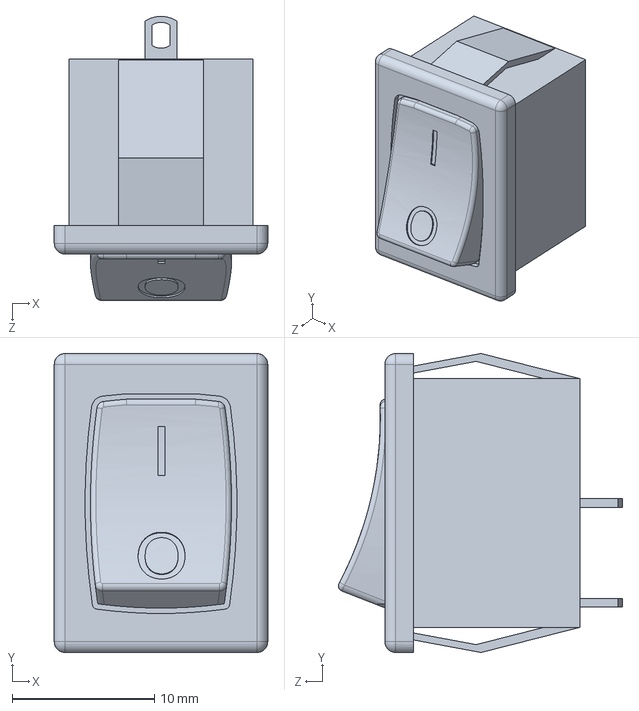
[picture p90: CAD file, 2015-11-09]
Solidworks/Concept9/rocker switch 1.SLDPRT
15.0 x 21.0 x 20.0 mm
