hsean/ECE-411-Practicum/Solidworks/Concept9/ServoMountA.SLDPRT

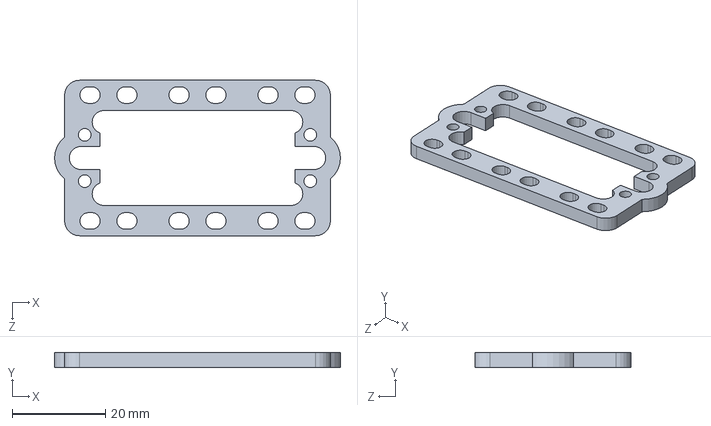
[picture p91: CAD file, 2015-11-09]
Solidworks/Concept9/ServoMountA.SLDPRT
61.2 x 3.17 x 33.3 mm
