hsean/ECE-411-Practicum/Solidworks/Concept9/10-32 Super Duty.SLDPRT

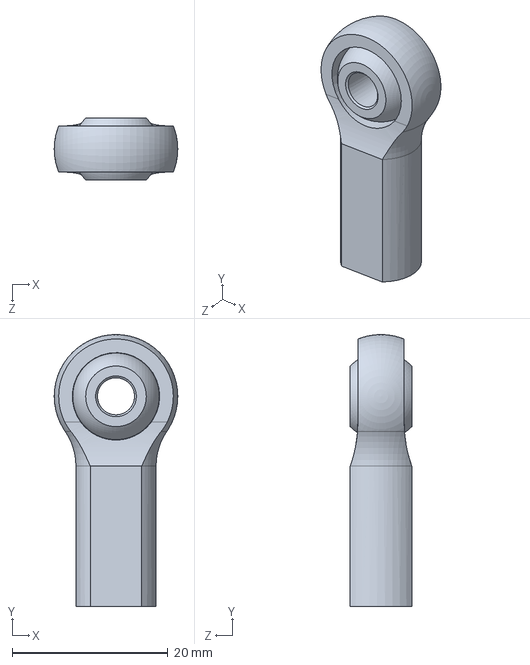
[picture p92: CAD file, 2015-10-25]
Solidworks/Concept9/10-32 Super Duty.SLDPRT
15.9 x 34.9 x 7.94 mm
