hsean/ECE-411-Practicum/Solidworks/Concept9/linear servo arm.SLDPRT

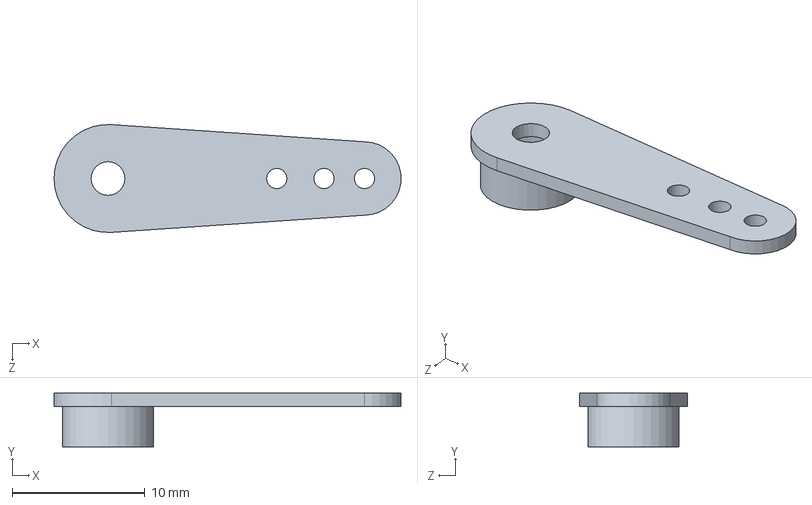
[picture p93: CAD file, 2015-10-25]
Solidworks/Concept9/linear servo arm.SLDPRT
26.1 x 4.06 x 8.11 mm
