hsean/ECE-411-Practicum/Solidworks/Concept9/ServoHornPlastic.SLDPRT

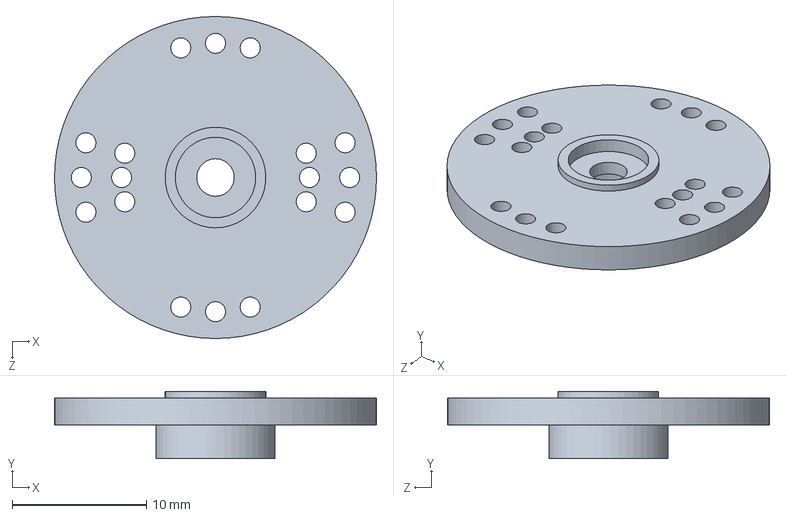
[picture p94: CAD file, 2015-10-25]
Solidworks/Concept9/ServoHornPlastic.SLDPRT
24.0 x 5.00 x 24.0 mm
