hsean/ECE-411-Practicum/Solidworks/Concept9/Voltage Regulator.SLDPRT

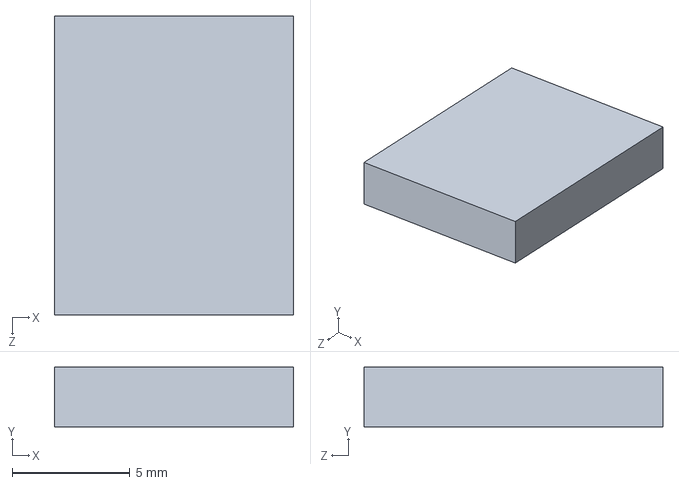
[picture p95: CAD file, 2015-10-25]
Solidworks/Concept9/Voltage Regulator.SLDPRT
10.2 x 2.54 x 12.7 mm
