hsean/ECE-411-Practicum/Solidworks/Concept9/Super Duty Ball Linkage.SLDPRT

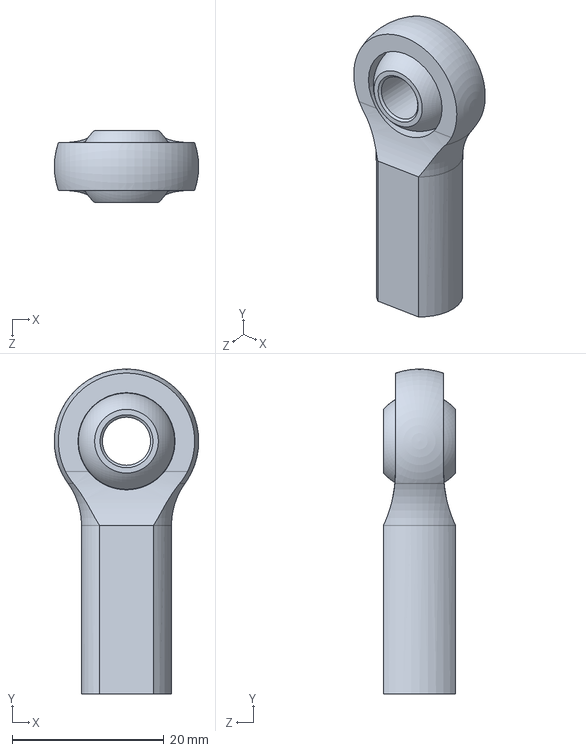
[picture p96: CAD file, 2015-10-25]
Solidworks/Concept9/Super Duty Ball Linkage.SLDPRT
19.1 x 42.9 x 9.53 mm
