hsean/ECE-411-Practicum/Solidworks/Concept9/HMSH-01.SLDPRT

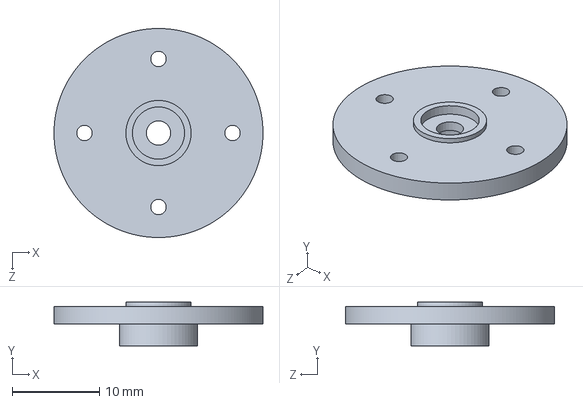
[picture p97: CAD file, 2015-10-25]
Solidworks/Concept9/HMSH-01.SLDPRT
24.0 x 5.00 x 24.0 mm
