hsean/ECE-411-Practicum/Solidworks/Concept9/ATMEGA328.SLDPRT

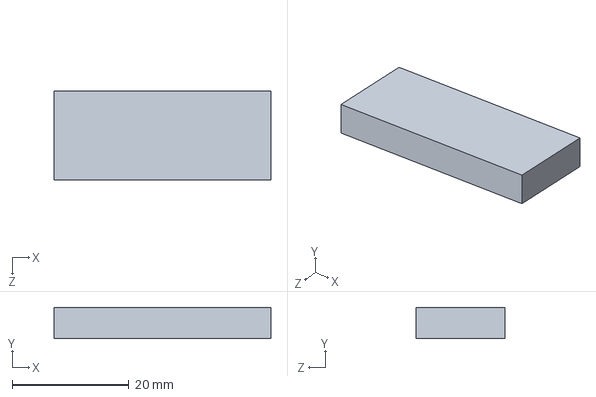
[picture p98: CAD file, 2015-10-25]
Solidworks/Concept9/ATMEGA328.SLDPRT
37.1 x 5.33 x 15.2 mm
