hsean/ECE-411-Practicum/Solidworks/Concept9/tige_filetee_generique.SLDPRT

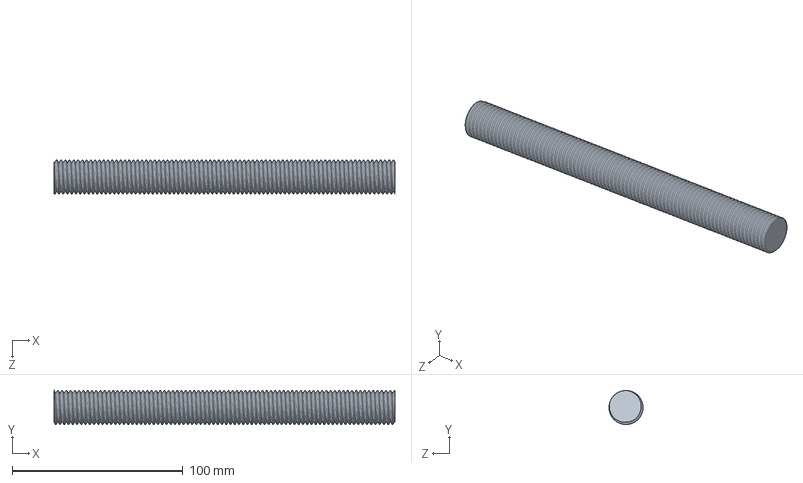
[picture p99: CAD file, 2015-10-25]
Solidworks/Concept9/tige_filetee_generique.SLDPRT
200.0 x 20.0 x 20.0 mm
