hsean/ECE-411-Practicum/Solidworks/Concept9/hs-422_sws.SLDPRT

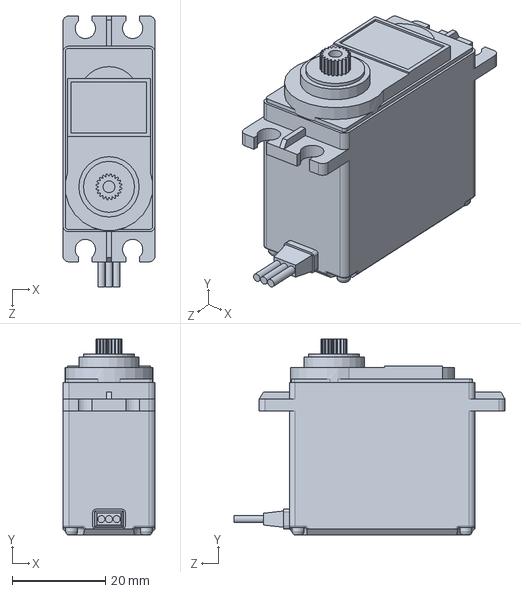
[picture p100: CAD file, 2015-10-25]
Solidworks/Concept9/hs-422_sws.SLDPRT
19.8 x 42.1 x 58.2 mm
