hsean/ECE-411-Practicum/Solidworks/Concept9/Beam Adaptor.SLDPRT

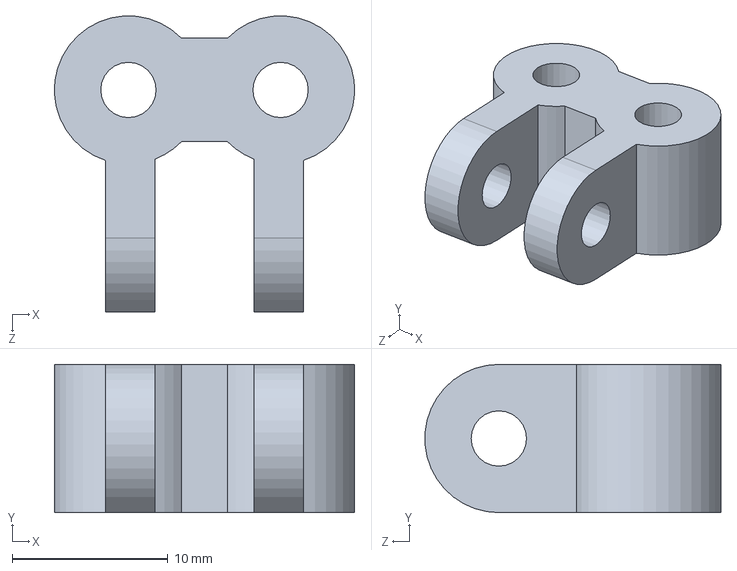
[picture p101: CAD file, 2015-10-25]
Solidworks/Concept9/Beam Adaptor.SLDPRT
19.3 x 9.53 x 19.0 mm
