hsean/ECE-411-Practicum/Solidworks/Concept9/4-40 THRDROD.SLDPRT

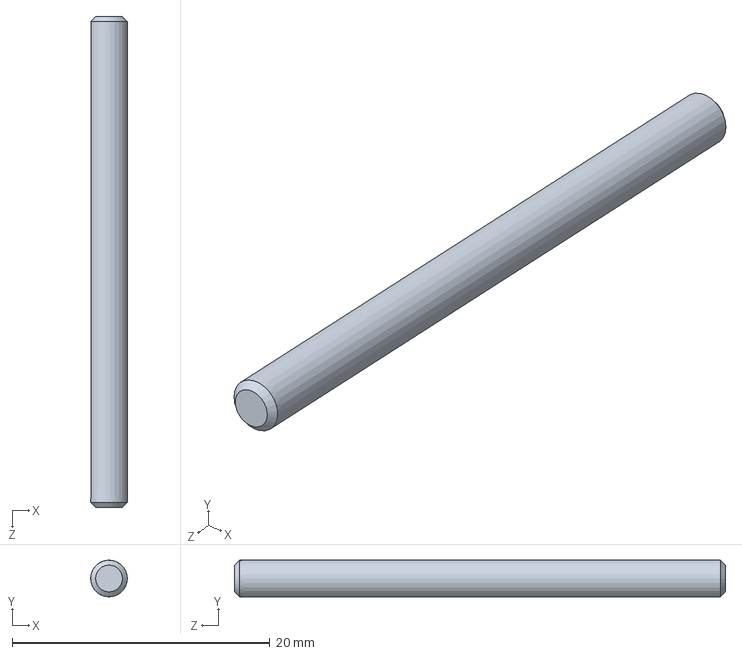
[picture p102: CAD file, 2015-10-25]
Solidworks/Concept9/4-40 THRDROD.SLDPRT
2.84 x 2.84 x 38.1 mm
