hsean/ECE-411-Practicum/Solidworks/Concept9/4-40 rod.SLDPRT

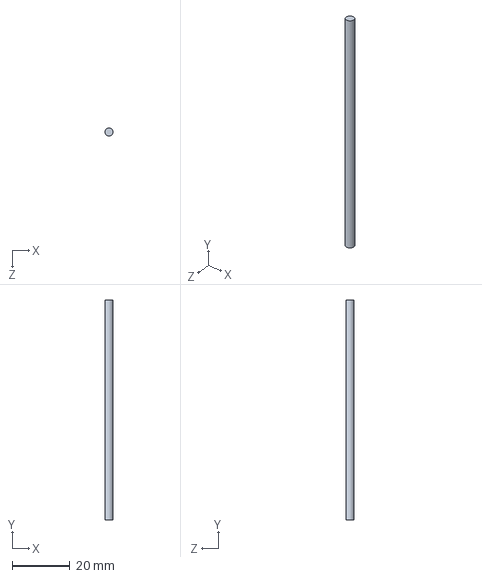
[picture p103: CAD file, 2015-10-25]
Solidworks/Concept9/4-40 rod.SLDPRT
2.84 x 76.2 x 2.84 mm
