hsean/ECE-411-Practicum/Solidworks/Concept9/6--32 3 threaded rod.SLDPRT

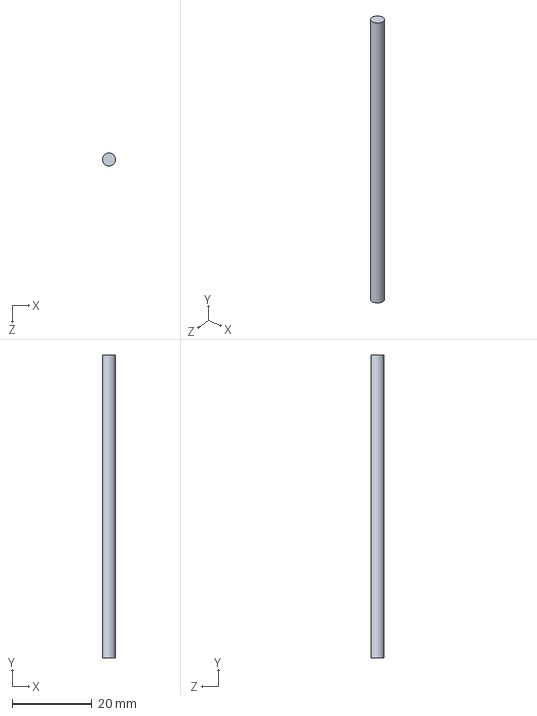
[picture p104: CAD file, 2015-10-25]
Solidworks/Concept9/6--32 3 threaded rod.SLDPRT
3.30 x 76.2 x 3.30 mm
