hsean/ECE-411-Practicum/Solidworks/Concept9/Sparkfun accelerometer.SLDPRT

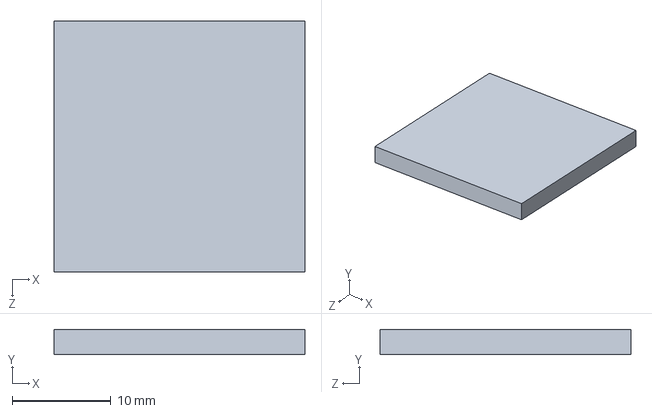
[picture p105: CAD file, 2015-10-25]
Solidworks/Concept9/Sparkfun accelerometer.SLDPRT
25.4 x 2.54 x 25.4 mm
