hsean/ECE-411-Practicum/(list of files, cad)

Other CAD files:
Solidworks/Concept9/Drawings_for_cutting/Base Side Panel 1inch.DXF
Solidworks/Concept9/Base_bottom.SLDPRT
Solidworks/Concept9/ServoArmSketch.SLDPRT
Solidworks/Concept9/4-40_875_aluminumStandoff.SLDPRT
Solidworks/Concept9/base_withParts.SLDPRT
Solidworks/Concept9/4-40 THRDROD 3in.SLDPRT
Solidworks/Concept9/CompleteModel_v9_wScrews.SLDASM
Solidworks/Concept9/Drawings_for_build/ServoMount.SLDDRW
Solidworks/Concept9/Drawings_for_cutting/Base Side Panel 1 inch.SLDDRW
Solidworks/Concept9/Drawings_for_cutting/Base Side Panel.SLDDRW
Solidworks/Concept9/Drawings_for_cutting/Base_bottom.SLDDRW
Solidworks/Concept9/Drawings_for_cutting/Base_top.SLDDRW
Solidworks/Concept9/Drawings_for_cutting/tray.SLDDRW
Solidworks/Concept9/Screws/cst1acrphms_unc_4_40_0_25_0_25.SLDPRT
Solidworks/Concept9/Screws/cst1crphms_unc_2_56_0_25_0_25.SLDPRT
Solidworks/Concept9/Screws/cst1crphms_unc_2_56_0_3125_0_3125.SLDPRT
Solidworks/Concept9/Screws/cst1crphms_unc_4_40_0_4375_0_4375.SLDPRT
Solidworks/Concept9/Screws/cst1crphms_unc_4_40_0_5_0_5.SLDPRT
Solidworks/Concept9/Screws/cst1crphms_unc_4_40_1_1.SLDPRT
Solidworks/Concept9/Screws/cst1crphms_unc_4_40_1_125_1_125.SLDPRT
Solidworks/Concept9/Screws/dhshcs_unc_4_40_0_5_0_5_0.SLDPRT
Solidworks/Concept9/Screws/dhshcs_unc_4_40_1_5_1_5_0.SLDPRT
Solidworks/Concept9/Screws/hshcs_unc_2_56_0_4375_0_4375.SLDPRT
Solidworks/Concept9/Screws/hshcs_unc_4_40_0_5_0_5.SLDPRT
Solidworks/Concept9/Screws/hshcs_unc_4_40_1_5_1_5.SLDPRT
Solidworks/Concept9/Screws/nut_2_servoCity.SLDPRT
Solidworks/Concept9/Screws/nut_4_servoCity.SLDPRT
Solidworks/Concept9/Screws/sbhms_unf_4_48_0_375_0_375.SLDPRT
Solidworks/Concept9/Screws/sphms_unc_2_56_0_375_0_375.SLDPRT
Solidworks/Concept9/Screws/sphms_unc_2_56_0_5_0_5.SLDPRT
Solidworks/Concept9/Screws/sphms_unc_6_32_0_375_0_375.SLDPRT
Solidworks/Concept9/Screws/washer_2_servoCity.SLDPRT
Solidworks/Concept9/Screws/washer_4_servoCity.SLDPRT
