hsean/ECE-411-Practicum/Pictures/Design Drawings/BaseAssembly.JPG

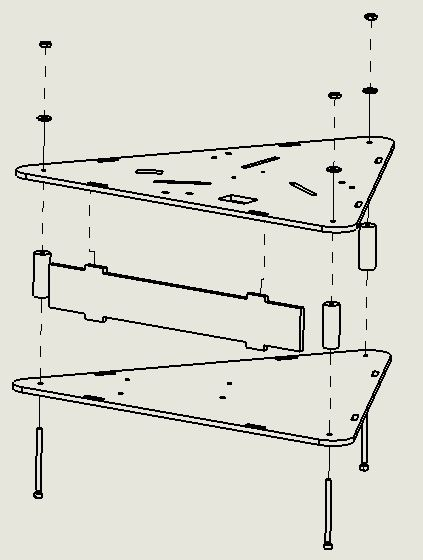
Pictures/Design Drawings/BaseAssembly.JPG
