hsean/ECE-411-Practicum/Pictures/Testing/TestingVoltageRegulator.png

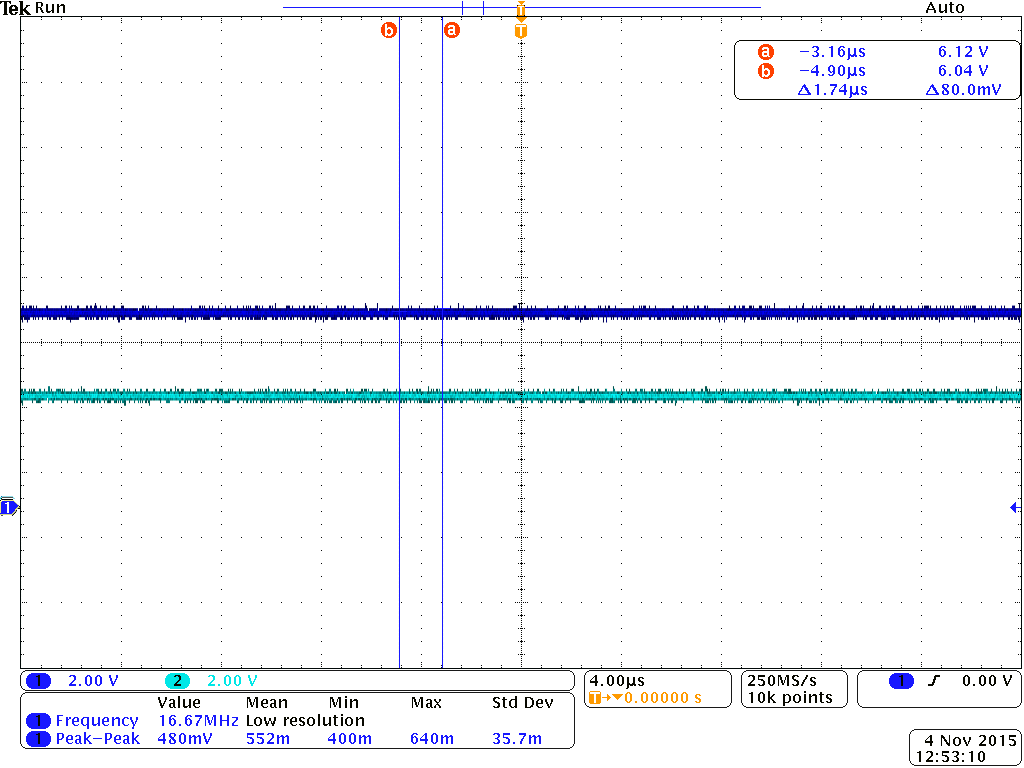
Pictures/Testing/TestingVoltageRegulator.png
