hsean/ECE-411-Practicum/(threads)

Thread 1 (2015-10-27):

Design New For Device Arm

hsean, 2015-10-27:
We need a new design for the way servos attach to the bottom of the table.  It must allow the connection to turn on both the X and Y axis.
**NOTE:** some useful keywords are "Ball and Socket Joint" and "Ball Pivot"

steelead, 2015-10-28:
I think there are two ways we could do this.

I couldn't find any straight up mount that provides us with a ball joint to connect some sort of rod onto, but I found this video (<https://www.youtube.com/watch?v=ZrZodwEHjew>) using threaded ball links (we could get from servocity: <https://www.servocity.com/html/2-56_threaded_ball_link.html>). Now he connects them straight into the board on the side, but I don't think we will be able to do that, and instead we will be mounting them to the underside of the table, so we should use one of these mounting brackets: <https://www.servocity.com/html/clear_hole_brackets.html>.

The second way is to use two more ball linkages (that we are already connecting from the servo horn/arm to the threaded rod: <https://www.servocity.com/html/ball_linkages.html>). This will provide us with a little less rotation, but I think it should work fine as there are a few other examples that use this method (<https://www.youtube.com/watch?v=j4OmVLc_oDw>, <https://www.youtube.com/watch?v=enlQMUE9df4>). While they don't have as much rotation ability as the first method, they can still rotate (probably) enough (<https://www.youtube.com/watch?v=gBVLrDIJKAE&feature=youtu.be&t=11m10s>). Again, for mounting it onto the table, we could use mounting brackets, or we could use the beam crossover adapters we picked out earlier (<https://www.servocity.com/html/beam_crossover_adaptor_a__5854.html#.VjB_JLerRhE>)

One last issue I was looking at is the length of the threaded rod (2-56 version), all of the stores I looked at online only had minimum lengths of 12 inches, with variable lengths scaling up from there. That seems pretty long, will we be able to cut those to the correct length we need them, or is there somewhere that we can buy some at the precise length we need them at?

steelead, 2015-10-28:
lynxmotion threaded ball links on sale - 2 pair: http://www.lynxmotion.com/p-340-ball-link-set-116-2-pair.aspx

Thread 2 (2015-10-27):

Microcontroller to servo communication

hsean, 2015-10-27:
We need to look into using the PWM lines on the micro-controller to move the servos.  If this can be done easily we can cut the servo controller out of our design.

hsean, 2015-10-29:
We decided we will use the servo controller.

Closed 2015-10-29.

Thread 4 (2015-10-27):

MP and Accelerometer communication

hsean, 2015-10-27:
We have yet to look into how the accelerometer really works.  Choose this task if you want to start looking into the accelerometer.

hsean, 2015-10-27:
I plan on working on this on Thursday.  I will also be in the Capstone Lab on Friday after 12:50 to work on prototyping the parts we have and hopefully start moving some servos.

hsean, 2015-10-29:
Uses TWI to communicate between the accelerometer and micro-controller.

hsean, 2015-11-23:
This communication is now working as of last week; therefore, issue is now closed.

Closed 2015-11-23.

Thread 6 (2015-10-29):

UART communication between 328 and Servo Controller

hsean, 2015-10-29:
We need to write some code to control the communication between the servo controller and micro-controller.  This will include initializing the mini maestro when the microcontroller boots up.

hsean, 2015-11-23:
As of last week the servo controller and micro-controller are now communicating.  This issue will now be closed.

Closed 2015-11-23.

Thread 7 (2015-11-06):

Dotstar LED SPI interface

hsean, 2015-11-06:
In order to add these LEDs changes need to be made to the circuit board.  Place all changes that need to be made and suggestions here.

hsean, 2015-11-06:
I was thinking we can add an on/off switch for the LEDs.  This way we can save power if we do not need the lights.

Thread 8 (2015-11-23):

Bring up the PCB

hsean, 2015-11-23:
We need to get the PCB from the faculty office and start checking that everything is correct.
