hsean/ECE-411-Practicum/Eagle/T04_Schematic.brd

## EAGLE design Eagle/T04_Schematic.brd (2015-12-10)

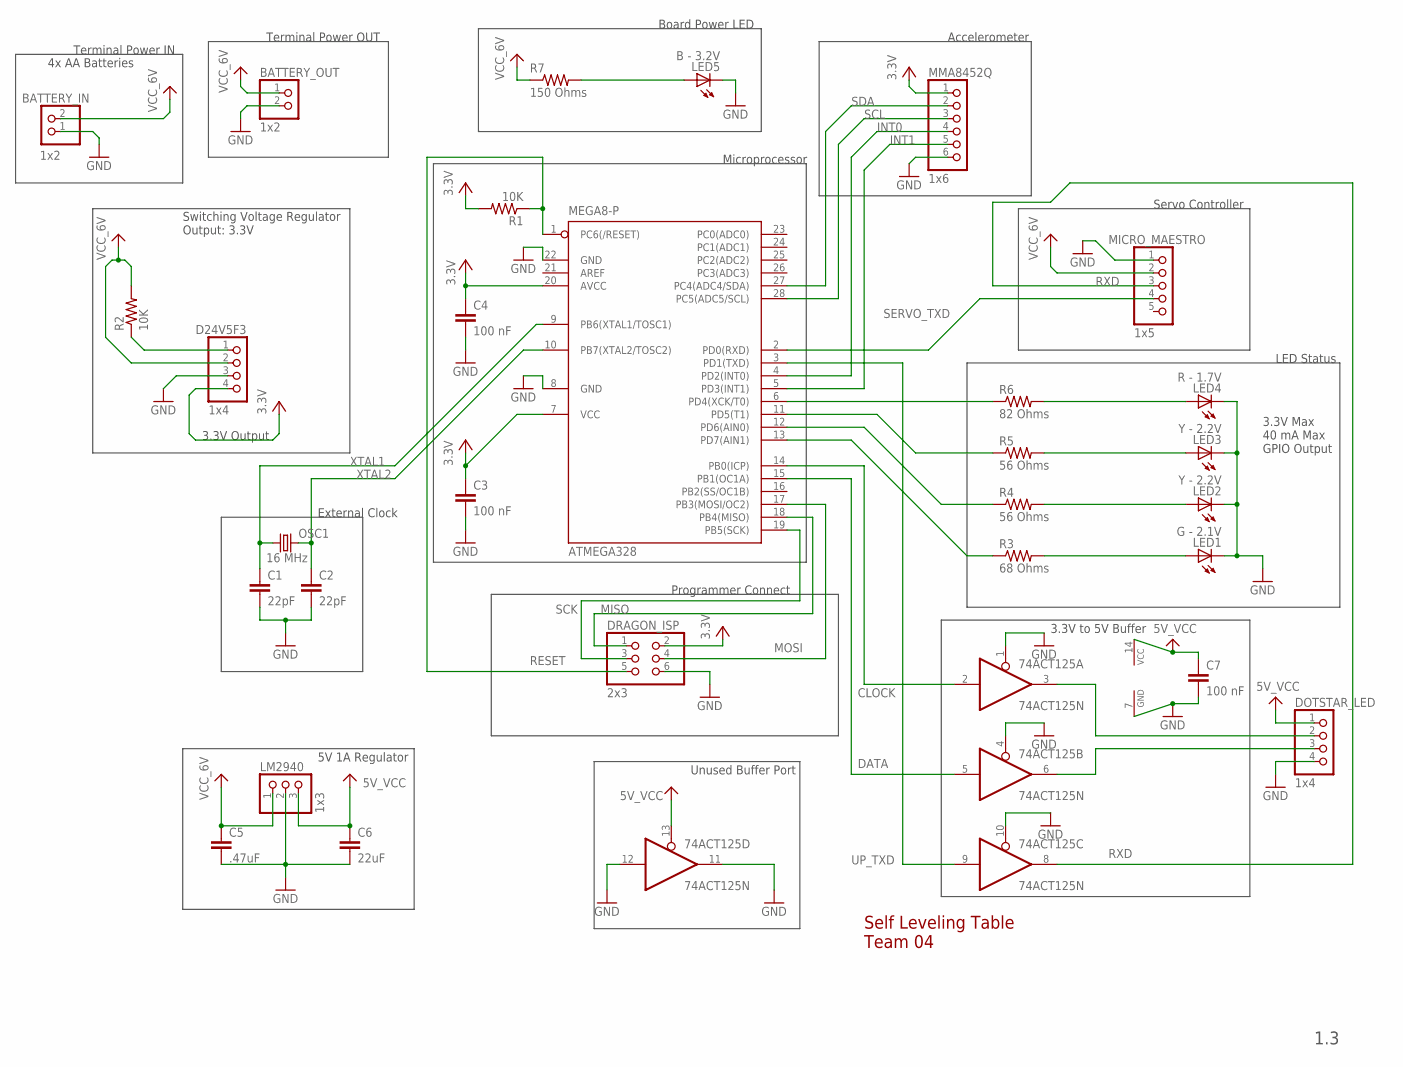
[picture p108: schematic T04_Schematic.sch]

Parts:
74ACT125: 74ACT125N; DIL14
ATMEGA328: MEGA8-P; DIL28-3
BATTERY_IN: 1x2; 1X02
BATTERY_OUT: 1x2; 1X02
C1, C2: 22pF; C1206
C3, C4, C7: 100 nF; C1206
C5: .47uF; C1206
C6: 22uF; C1206
D24V5F3: 1x4; 1X04
DOTSTAR_LED: 1x4; 1X04
DRAGON_ISP: 2x3; 2X03
LED1: G - 2.1V; 1206
LED2, LED3: Y - 2.2V; 1206
LED4: R - 1.7V; 1206
LED5: B - 3.2V; 1206
LM2940: 1x3; 1X03
MICRO_MAESTRO: 1x5; 1X05
MMA8452Q: 1x6; 1X06
OSC1: 16 MHz; HC49US
R1, R2: 10K; M1206
R3: 68 Ohms; R1206
R4, R5: 56 Ohms; R1206
R6: 82 Ohms; R1206
R7: 150 Ohms; R1206

Connections:
5V_VCC: 74ACT125.13 (OE), 74ACT125.14 (VCC), C6.1, C7.1, DOTSTAR_LED.1, LM2940.3
CLOCK: 74ACT125.2 (I), ATMEGA328.14 (PB0(ICP))
DATA: 74ACT125.5 (I), ATMEGA328.15 (PB1(OC1A))
GND: 74ACT125.1 (OE), 74ACT125.4 (OE), 74ACT125.7 (GND), 74ACT125.10 (OE), 74ACT125.11 (O), 74ACT125.12 (I), ATMEGA328.8 (GND), ATMEGA328.22 (GND), BATTERY_IN.1, BATTERY_OUT.2, C1.2, C2.2, C3.2, C4.2, C5.2, C6.2, C7.2, D24V5F3.3, DOTSTAR_LED.4, DRAGON_ISP.6, LED1.C, LED2.C, LED3.C, LED4.C, LED5.C, LM2940.2, MICRO_MAESTRO.1, MMA8452Q.6
INT0: ATMEGA328.4 (PD2(INT0)), MMA8452Q.4
INT1: ATMEGA328.5 (PD3(INT1)), MMA8452Q.5
MISO: ATMEGA328.18 (PB4(MISO)), DRAGON_ISP.1
MOSI: ATMEGA328.17 (PB3(MOSI/OC2)), DRAGON_ISP.4
unnamed: LED5.A, R7.2
unnamed: LED1.A, R3.2
unnamed: LED2.A, R4.2
unnamed: LED3.A, R5.2
unnamed: LED4.A, R6.2
unnamed: 74ACT125.3 (O), DOTSTAR_LED.2
unnamed: ATMEGA328.11 (PD5(T1)), R5.1
unnamed: ATMEGA328.12 (PD6(AIN0)), R4.1
unnamed: ATMEGA328.6 (PD4(XCK/T0)), R6.1
unnamed: ATMEGA328.13 (PD7(AIN1)), R3.1
unnamed: 74ACT125.6 (O), DOTSTAR_LED.3
RESET: ATMEGA328.1 (PC6(/RESET)), DRAGON_ISP.5, R1.1
RXD: 74ACT125.8 (O), MICRO_MAESTRO.3
SCK: ATMEGA328.19 (PB5(SCK)), DRAGON_ISP.3
SCL: ATMEGA328.28 (PC5(ADC5/SCL)), MMA8452Q.3
SDA: ATMEGA328.27 (PC4(ADC4/SDA)), MMA8452Q.2
SERVO_TXD: ATMEGA328.2 (PD0(RXD)), MICRO_MAESTRO.4
UP_TXD: 74ACT125.9 (I), ATMEGA328.3 (PD1(TXD))
VCC: ATMEGA328.7 (VCC), ATMEGA328.20 (AVCC), C3.1, C4.1, D24V5F3.4, DRAGON_ISP.2, MMA8452Q.1, R1.2
VCC_6V: BATTERY_IN.2, BATTERY_OUT.1, C5.1, D24V5F3.2, LM2940.1, MICRO_MAESTRO.2, R2.2, R7.1
V_REG_RESET: D24V5F3.1, R2.1
XTAL1: ATMEGA328.9 (PB6(XTAL1/TOSC1)), C1.1, OSC1.1
XTAL2: ATMEGA328.10 (PB7(XTAL2/TOSC2)), C2.1, OSC1.2

Notes on the sheet:
4x AA Batteries
1.3
3.3V Max 40 mA Max GPIO Output
3.3V Output
Terminal Power IN
Terminal Power OUT
Switching Voltage Regulator Output: 3.3V
Self Leveling Table Team 04
Accelerometer
Servo Controller
LED Status
Programmer Connect
Microprocessor
Board Power LED
External Clock
3.3V to 5V Buffer
5V 1A Regulator
Unused Buffer Port

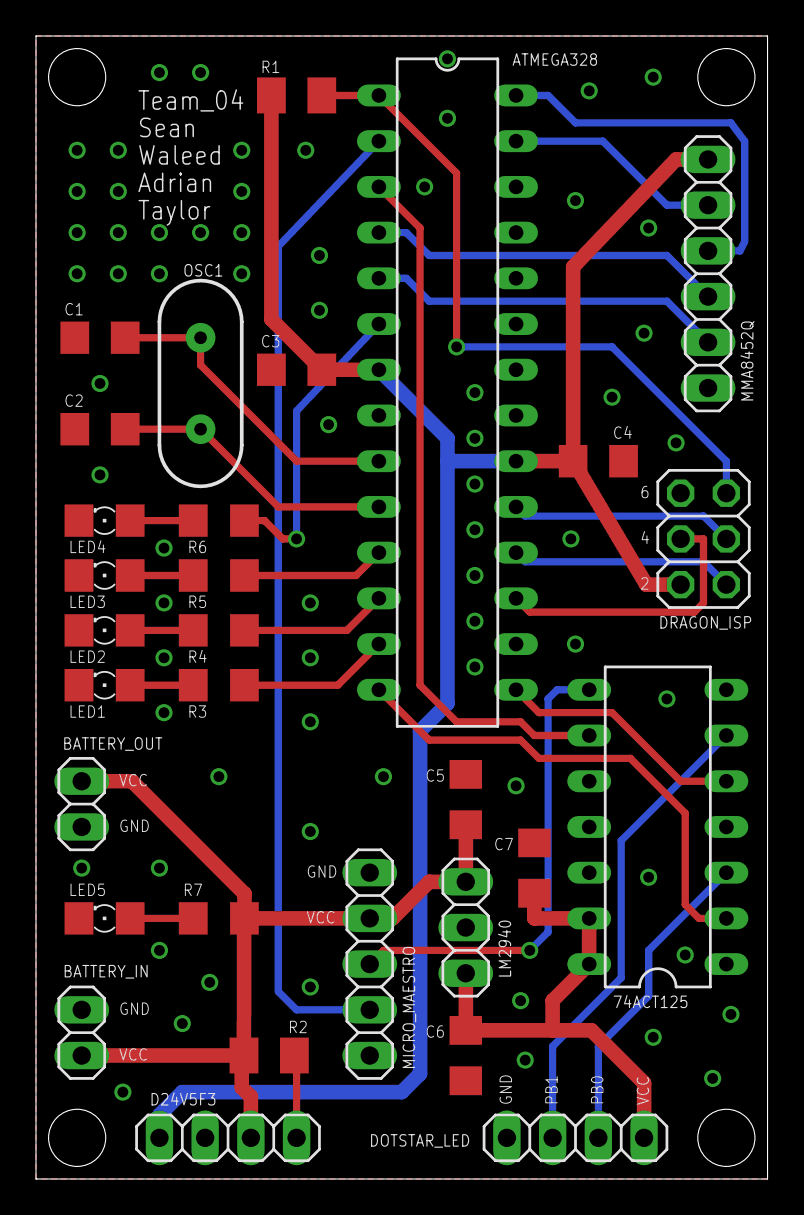
[picture p109: board T04_Schematic.brd from above]

Board: 2 copper layers, 40.6 x 63.5 mm, 30 parts (0 on the bottom side), 31 nets.
