hsean/ECE-411-Practicum/(commit log)

2015-10-21 Eagle files
    Just adding some documentation for Eagle CAD
    [self leveling tray schematic.sch]
2015-10-25 Solidworks Models
    Adding models I have been working with. I need help with the final ball
    joint.
    [10-32 Super Duty.SLDPRT, 10-32 Super Duty.STEP, 2-56 THRDROD.SLDPRT, 4-40 THRDROD 3in.SLDPRT, 4-40 THRDROD.SLDPRT, 4-40 rod.SLDPRT, 585632.STEP, 5holeBeam.SLDPRT]
2015-10-27 voltage regulator info
    added datasheet and schematic for Pololu Voltage Regulator
2015-10-28 Eagle Schematic 1.0
    First draft schematic.
    Taylor Griffin
2015-10-28 Added Screw equation
    Just a simple equation to figure out the diameter of threaded bar
2015-10-28 Schematic & Layout
    Fixed ERC errors in schematic.
    Created (practice?) layout.
    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
    [self leveling tray schematic.brd, self leveling tray schematic.sch]
2015-10-31 Schematic Version 1.2
    Added changes suggested by Andrew.
    Added LEDs and grounded unused GPIO.
    Email from Andrew:
    Hi Taylor!
    > Could you take a look at our current schematic? It passes ERC right
    now,
    > but I'm not sure if I'm missing something critical.
    - You need 100 nF bypass caps on the 328's VCC and AVCC pins.
    - Use a 3.3V supply symbol, not wires, for your supply.
    - Your regulator absolutely needs filter caps - large filter caps. Read
    the data sheet.
    - What's your battery voltage? what kind of batteries? note it in the
    schematic.
    - What kind of accelerometer? Note it in the schermatic.
    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
    [self leveling tray schematic.brd, self leveling tray schematic.sch]
2015-10-31 Schematic Update
    Minor changes to Text formatting for names/values etc.
    [self leveling tray schematic.sch]
2015-11-02 Schematic Updates
    Updated with better supply layout and more organization.
    Also changed filename to have team name.
    Still Need: Oscillator, LEDs, UART review
    [T04_Schematic.sch, self leveling tray schematic.brd, self leveling tray schematic_OLD.sch]
2015-11-03 Updating gant chart and adding crystal wire guide
    just updating this documentation
2015-11-08 Small Schematic Update
    Minor tweaks, notes
    [T04_Schematic.sch]
2015-11-08 Example code for programming the ATmega328 for blinking an LED
2015-11-09 Schematic and Layout
    Added DRC passing PCB layout.
    Updated Schematic, added buffer for 5V LED control.
    [T04_Schematic.brd, T04_Schematic.sch]
2015-11-09 Solidworks Parts
    Adding all the parts needed for concept 5 and the rendered images of
    concept 5
    [10-32 Super Duty.SLDPRT, 2-56 THRDROD.SLDPRT, 2-56 ball link.SLDPRT, 4-40 THRDROD 3in.SLDPRT, 4-40 THRDROD.SLDPRT, 4-40 rod.SLDPRT, 4-40_1in_aluminumStandoff.SLDPRT, 4-40_875_aluminumStandoff.SLDPRT]
2015-11-09 DRC Error Free Layout + Schematic Update
    Made changes to layout based on feedback from class.
    Added linear regulator to schematic for 5V supply.
    Will need group review.
    [T04_Schematic.brd, T04_Schematic.sch]
2015-11-10 current code for testing uart
2015-11-10 edited test uart code initialization to be more detailed.
2015-11-10 Added Feedback Changes to Layout
    [T04_Schematic.brd]
2015-11-10 Model and WPR Update
    Compiled all of are weekly progress reports into a single text file and
    added some new concept pictures for a redesign of the model.
    [10-32 Super Duty.SLDPRT, 2-56 THRDROD.SLDPRT, 2-56 ball link.SLDPRT, 4-40 THRDROD 3in.SLDPRT, 4-40 THRDROD.SLDPRT, 4-40 rod.SLDPRT, 4-40_1in_aluminumStandoff.SLDPRT, 4-40_875_aluminumStandoff.SLDPRT]
2015-11-10 Got UART Code Working
    Adrian's Working Code
2015-11-11 Added batch servo control function
2015-11-11 renamed working_usart_test_code.c to test_communications.c and added steps for communicating with accelerometer using waleed's i2c functions
2015-11-12 New Concept Pictures
    Moved the LEDs. Changed acrylic to 1/8 inch. Added different colored
    trays.
2015-11-14 Final(?) Layout
    Increase board size for more room to solder.
    Improved power signal layout.
    Added missing GND and VCC to Dotstar LEDs.
    [T04_Schematic.brd, T04_Schematic.sch]
2015-11-14 Fixed Typo in Component Name
    [T04_Schematic.brd, T04_Schematic.sch]
2015-11-15 Block Diagram Draft
    Just a powerpoint file
2015-11-15 Concept Images
    Now with screws!
2015-11-15 Minor Tweaks and Fixes
    [T04_Schematic.brd, T04_Schematic.sch]
2015-11-15 Added Andrew's Changes and Some more Silk Screen ID
    Hi Taylor,
    > We've been getting great feedback from you on our schematic/layout and
    I
    > was wondering if you could take one last look at our layout to see if
    we
    > missed anything major before we submit it.
    I didn't have much time to look, but here you go:
    Schematic:
    - IMPORTANT: Chip "74ACT125" has an uninvoked gate. It's a quad buffer
    part, and one of the buffers isn't hooked up. Use the INVOKE command in
    eagle and click on that part to get the fourth buffer. Tie the input and
    the enable line to low/high as you see fit -- but don't leave it
    floating, like it is now.
    - IMPORTANT: Chip "74ACT125" needs aq bypass cap.
    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
    [T04_Schematic.brd, T04_Schematic.sch]
2015-11-15 Fixed Typo
    [T04_Schematic.brd]
2015-11-15 Fixed Silkscreen Position as Rendered by OSHPark
    [T04_Schematic.brd]
2015-11-15 Minor Changes for OSHPark -- PRINTED
    Moved vias and text to make it pretty.
    -- This File Uploaded to Print!!!
    [T04_Schematic.brd]
2015-11-19 v0.1 of the bill of materials
    Fill this out more as we purchase parts. The spreadsheet can be found
    in google sheets.
2015-11-20 Number Mapping Code
    Added some example code for mapping one range of integers to another.
    This example uses angles and PWM values.
2015-11-21 Initial commit of main program. Stuff to add: LED strip code, error checking for status LEDs, calculation of servo positions, possibly change to fast read mode.
    [mainProgram.c]
2015-11-23 Added example code we used to test the accelerometer in arduino
2015-11-24 Code and diagram update
    Added some untested code of the class implementation and updated the UML
    Class Diagram.
    [ECE411_T04_LevelingTable.sdf]
2015-11-25 test code to control 3 servos with accelerometer x y z measurements
2015-11-25 accl_controlled_servos_test.c: edited outdated function comment mainProgram.c: updated setMultipleTargets() function to work with an array of entries rather than fixed number
    [accl_controlled_servos_test.c, mainProgram.c]
2015-11-26 Acrylic after laser cut
    Adding the pictures of the acrylic I took on my phone on Wednesday.
2015-11-30 Re-adding deleted file
    accidentally removed powerpoint file while merging. Adding the file
    back.
2015-12-02 Example LED Strip Code
    Added code for arduino and raspberry pi from adafruit.com
2015-12-02 Some Servo Notes
2015-12-02 edited code for accelerometer fast mode
2015-12-05 Dotstar Code Partially Finished
    So, I worked on the dotstar code and some new code for configuring pins.
    will need to test pin configuration code in Atmel studio since all of
    the register names really confuse Visual Studio.
2015-12-05 Current test code for putty: allows you to print the expected servo angle movements to screen. Other test code also in this file but commented out.
2015-12-06 Adrian's newest code
    Some math errors were fixed
    [derp_servo_movements.c]
2015-12-07 A couple changes to class implementation
2015-12-09 Reorganizing
    Getting rid of old solidworks files and organizing pictures a little
    better.
    [10-32 Super Duty.SLDPRT, 10-32 Super Duty.STEP, 16Mhz Clock.SLDPRT, 2-56 THRDROD.SLDPRT, 2-56 ball link.SLDPRT, 4-40 THRDROD 3in.SLDPRT, 4-40 THRDROD.SLDPRT, 4-40 rod.SLDPRT]
2015-12-09 Updating Bill of Materials
    Just adding more parts from the parts spreadsheet.
2015-12-10 updating model
    [CompleteModel_v9_wScrews.SLDASM, HubMountC.SLDPRT, ServoMount.SLDDRW, cst1acrphms_unc_4_40_0_25_0_25.SLDPRT]
2015-12-10 Added Resistor and LED Voltages
    [T04_Schematic.brd, T04_Schematic.sch]
2015-12-10 cleaned up code
    I got rid of a commented out function and got rid of pointless comments
    in main. I also added some comments for Dotstar but the LED code and
    servo calculations could use some more documentation.
2015-12-10 Updated specifications for current project
2015-12-10 Added Example code references, and made edits to mainprogram (added some \#defines, fixed some commends
    [mainProgram.c]
2015-12-10 Final List of Components
    This is a complete Bill of Materials.
2016-07-11 power point to PDF
    Added a PDF version of the power point presentation for easy reading on
    github
