hsean/ECE-411-Practicum/(notices)

Notices in the files:
parts and their libraries:
SparkFun-FreqCtrl: Licensing: Creative Commons ShareAlike 4.0 International - https://creativecommons.org/licenses/by-sa/4.0
